zhuj27519-del/AirMonitor/history/stm32/AirMonitor_KEY3_diagnostic/REPORT.md

# AirMonitor KEY3 专项诊断

完成日期：2026-10-28。**KEY3 已确认连通，GUI 与 CLI 完整 DRC 均为 0 错误，可进入下一轮制造审核。**本结论只关闭 KEY3 阻断，不等于整机安全上电或 SMT 下单放行。

| 项目 | 结果 |
|---|---|
| 当前使用工程 | `outputs/AirMonitor_V1_first_article/hardware/EasyEDA/AirMonitor V1 - First Article.eprj3`，不是 `AirMonitor_V1_first_article - fix` |
| 识别依据 | 当前窗口唯一存活用户会话、工程 UUID 与该绝对文件路径 SHA-256 一致；PCB UUID `0d571ee1a4bcf754`；实时走线与磁盘原生几何一致 |
| 原始问题原因 | 早先缺少 KEY3 层间过孔；该过孔已在上一轮加入。之后旧会话仍报两个 Connection Error，但已保存几何与本次通过检查的几何一致。旧会话连通性状态未同步是最符合证据的解释；具体内部缓存/更新缺陷未证实 |
| KEY3 是否真正连通 | **是，按铜几何验证**：U1.44/PB5、R6.2、SW3.1 在同一连通分量；不是只比较网络名称 |
| GUI / CLI 是否一致 | **一致，均 0 错误**。GUI 本轮重新点击完整检查，141 项，完成显示时间 2026-10-27 23:58:30、耗时 00:06；CLI 严格详细模式返回空错误数组 |
| 本轮是否修复 | **没有改线、改过孔或改规则**，未发现需要修复的真实断线 |
| GND 铺铜 | 本轮未改铜几何，所以未重复重填；读取到已有顶/底两个实际填充对象，新 Gerber 两层均有铜区 |
| 最终 DRC 错误数 | **0**；旧报告 2 项，本轮同设计复核 0 项 |
| 新工程路径 | `hardware/EasyEDA/AirMonitor V1 - First Article.eprj3`（相对本报告目录，独立审核副本，电路未修改） |
| 下一轮制造审核 | **可以进入**；电源、机械/线束、SMT 贴装审核等此前待验事项不在本轮放行范围 |

## 两个走线与过孔

所有坐标为 EDA 原生数据坐标换算的 mm；此前错误位置是走线标记中心，不是实际断点。

| UUID | 对象 / 网络 / 铜层 | 实际几何与状态 |
|---|---|---|
| `50ed7851da96bd02`（e1557） | LINE / KEY3 / 顶层 1 | (40.75013186,39.25001294) → (39.67139640,39.25001294)，宽 0.248412；起点在 U1.44 铜盘内，末端与过孔环形铜相交 |
| `3dc5ae6a88fe8cb1`（e1564） | LINE / KEY3 / 底层 2 | (39.82328840,39.09812094) → (39.67139640,39.25001294)，宽 0.248412；连接底层 KEY3 主干及同一过孔环形铜 |
| `9b31158553647615` | NORMAL 镀铜通孔 / KEY3 / 顶底层 | 中心 (39.67139640,39.25001294)，原生孔径/外径约 0.30/0.60；孔壁连接顶底焊环。不是把钻孔中心误当成实铜 |

独立计算包含 12 段走线、1 个镀铜过孔和 3 个实际焊盘。焊盘坐标/形状从官方 pin API 读取，走线和过孔从原生文件及 API 交叉核对。按铜宽、同层接触、环形铜交集及镀铜孔壁建立连接图，16 个对象全部可从 U1.44 到达；仅在计算中移除该过孔时，U1.44 与 R6.2/SW3.1 断开，验证了层间通路的重要性。未依赖 GND 铜区连接 KEY3，未进行实物电测。

## 为何与旧报告不同

旧报告调用 `pcb_Drc.check(true,false,true)`，本轮调用 `pcb_Drc.check(true,true,true)`：中间参数仅控制是否显示 UI，首尾参数均为严格检查及详细错误输出，不是缩小检查范围。GUI 完整检查也独立执行，并非只查看网络过滤结果。

对封存交付 ZIP 与当前 PCB 逐条比较：有效走线、焊盘、过孔、元件布局、铺铜和设计规则未改变；有效语义差异仅铜区/铜框显示隐藏。e1557 的编辑 ticket 更新，但几何、网络和层保持完全相同；有两个临时走线删除记录，均不构成当前铜对象。时间戳和客户端标识变化不代表电路版本变化。

因此，不能把上轮结果简单解释为当前仍有缺孔，或把 GUI 0 错误归因于更宽松的规则。当前证据支持旧会话连通性判定陈旧/未同步；没有调试到 EDA 内部实现，故不把某个缓存缺陷写成已证实原因。此前封存报告的 NO-GO 历史记录保持不动，本报告仅更新 KEY3 这一项结论。

## 文件与保护边界

- `original_project_backup.zip`：本轮任何检查前备份的当前可编辑工程，包含工程索引、PCB、原理图、面板和配置；不混入历史自动备份目录。
- `hardware/EasyEDA/`：独立源工程副本；打开 `.eprj3` 时必须保留相邻文件夹。
- `manufacturing/`：新导出的 Gerber、三类 Drill、原生及 JLC 格式 BOM/CPL。42 元件总表；41 元件 SMT 表，J5 单列手焊。仅供下一轮审核，未提交订单。
- `verification/current-cli-drc.txt`、`gui-drc-observation.json`：本轮原生 DRC 结果及 GUI 观察记录。
- `verification/key3-independent-connectivity.json`：具体连接路径、接触裕量、原生数据比较及负对照。
- `verification/identity-and-backup.json`、`candidate-integrity.json`：工程身份、备份哈希、原始文件不变检查、网表及制造文件一致性。

本轮未改电源、布局、固件或任何设计规则，未重跑全板布线，未忽略 DRC。冻结 ZIP 的 SHA-256 保持不变；当前用户工程文件也逐项检查未被本轮改写。制造候选文件的 PCB/原理图 182 个符号引脚一致，三处 KEY3 引脚均正确；BOM/CPL 42 元件一致，Gerber ZIP CRC 和三类钻孔提取一致性通过。
