zhuj27519-del/AirMonitor/history/stm32/AirMonitor_V1_first_article - fix/FINAL_REPORT.md

# AirMonitor V2 — V1 首版打样冻结报告

2026-10-27。V1 是交付批次名，产品仍为 AirMonitor V2。本交付冻结现有功能、固件和元件选型，不再进行 P3/P4 优化。未提交订单、未上传制造文件、未进行实物上电。

Gerber、Drill、BOM、CPL、可编辑源工程与预览均已导出。可选 STEP 导出超时，本包不包含 STEP，也不使用旧版本 STEP 替代；不再为此重复自动导出。

**制造结论：NO-GO（存在未关闭生产阻断项）。**
**整机安全上电：未验证，不予直接上电放行。直接交付嘉立创 SMT：NO-GO，须完成装配审核。**

| 项目 | 修改前 | 最终实测/检查结果 |
|---|---:|---|
| ERC 错误 | 0 | 0；实际执行，passed=True |
| DRC 错误 | 24：23 项连通性错误 + 1 项网表同步错误 | 2 |
| 实际未连接网络 | 8 | 1；KEY3 |
| 原理图/PCB 同步 | 1 项错误 | 通过；182 个符号引脚逐项比对 |
| 计划连接核对 | 152 个连接 | 全部一致 |
| GND 铜区 | 布线后需重填 | 2 个实际填充对象；顶/底层 Gerber 均包含铜区 |
| 尚未核验的连接器/封装 | 见下文 | 传感器端配套插头、实物 Pin 1、线束；J5/按键实际高度和装配配合；全板 CPL 在嘉立创贴装预览中的旋转、Pin 1、底面朝向尚未人工确认 |
| 是否可制造 | 未放行 | NO-GO（存在未关闭生产阻断项） |
| 是否可安全上电 | 未实测 | **不能宣称通过**；先执行下述分阶段验收 |
| 是否可直接交付嘉立创 SMT | 未审核 | **NO-GO**：双面 SMT、J5 通孔手焊、料号可贴装性/库存及贴装旋转尚未完成下单审核 |

## 对应错误的收敛修改

1. 原 23 项不是 23 个焊盘：其中 21 个是必需连接焊盘，2 个是 KEY3 顶/底层走线。逐项位置、网络和分类见 `verification/v1-connection-and-width-audit.json`。未把它们改为 NC 或忽略错误。
2. eFuse OUT 4–8、IN 9–13 采用厂家 0.20×0.60mm 焊盘后的局部引出线；保持约 0.50mm 主供电走线。EF_EN、EF_ILIM、EF_DVDT、OVP_DIV 的局部控制线采用 0.15mm。未降低铜间距规则。电源入口曾出现的一段 0.20mm 细线已恢复为 0.50mm。
3. C6.2、U2.2 补地连接。KEY3 在 (39.6714, 39.2500)mm 补一个 0.30/0.60mm 过孔，但最终 DRC 仍报两条走线未连接，不能据此宣称 KEY3 已修复。该网络是 U1.44/PB5、R6.2 与 SW3.1 的必需连接，不是 NC。
4. 重新同步原理图变更以修复网表元数据不一致；重建 GND 后执行最终检查。
5. U3.2(PGOOD)、U3.19(IMON)、U3.20(FLT)、U4.1(OUTA) 及未使用 MCU GPIO 按功能允许 NC。NC 与必需连接分开处理。

## P1/P2 汇总及冻结边界

P1 已处理 USB-C 原来的 4 项间距错误、双层地铜、USB4125 电源接口、独立 CC 下拉、PTC/TVS/eFuse 电源链、MCP1826S 3.3V 稳压、八针 PMS 转接线定义及 LCD 安装孔。

P2 已加入的 TLV6700 过压检测保留为冻结设计，不再添加保护功能：U4 的 OUTB 开漏输出拉低 U3.EN；124k/10k 精密分压名义阈值 5.36V。按 TI 全温阈值、输入漏电、电阻初始误差和温漂计算，静态上升阈值约 5.270～5.451V；计算不是实测。eFuse 内部 OVP 保留为后备。未声称具有经过测试的瞬态钳位、完整热插拔保护或模块绝对最大值保证。

已有 P2 修正同时收敛到本包：U3 外围铜盘/焊膏开口采用 TI RVC 示例；EP 两个 1.15×1.47mm 开口、约 81.27% 覆盖，0.10mm 钢网参考。U4 按 TI DDC 推荐 1.10×0.60mm 焊盘、0.95mm 节距核对。J4 两个固定焊盘从 x=±9.85mm 修正至 ±9.35mm，与 JST PH 安装图的横向定位一致。原理图和 PCB 内嵌封装资源读回一致。

固件与 P1 提交 `ad4e2493cffe687d613dfba4a7fd445f3fbed14e` 相比未改变。沿用已实际执行的 CubeIDE 编译（0 错误/0 警告）及 107 项 ARM 协议解析断言记录；本轮未重跑、未上硬件。保留源代码和 ELF/HEX/BIN。

## 关键封装核验范围

| 对象 | 已完成的软件/图纸核验 | 不宣称已完成的事项 |
|---|---|---|
| J1 USB4125-GF-A-0190 | GCT 图纸、六针/四壳脚、A9/B9 0.76×1.20mm 铜盘、0.60×1.20mm 壳槽及 CC 独立下拉 | 插头插拔、板边和外壳实配 |
| U3 TPS25940 | 20 脚+EP 引脚网络、0.50mm 节距、厂家焊盘与钢网尺寸、EP 直连 GND | 焊接空洞率、实测限流/热保护/瞬态响应 |
| U4 TLV6700 | 六针逻辑和接线、厂家推荐焊盘、分压计算 | 实测动作/释放阈值和启动瞬态 |
| U2 MCP1826S | IN1/GND2/OUT3/tab4；2.30mm 节距；现有扩大铜盘覆盖厂家推荐接触区域 | 两层 PCB 热阻、满载温升、实际电容偏压后的有效容量 |
| U1 STM32G0B1CBT6 | 非 N 版本引脚、电源/SWD、48脚0.50mm节距、7×7mm本体；库0.27×1.50mm铜盘与ST0.30×1.20mm示例差异已记录，未误称完全相同 | 装配厂贴装旋转终审、实板焊接验收 |
| J2/J3/J4 JST PH | 2mm节距、各针网络；J2固定盘横向距边针约2.40mm、J3/J4约2.35mm；J4固定盘已纠正；J4在底面 | 线束配套插头、锁扣空间、实际底面安装方向验收 |
| F1/D1、标准R/C及开关 | 精确BOM料号、极性/网络、库尺寸及DRC；未宣称逐件实物验证 | 非关键标准封装未做完整厂家叠图，装配厂复核型号/极性/钢网与供料 |

主要电源干线仍约 0.50mm；QFN 邻近短段存在 0.20mm，3V3 既有局部颈部约 0.248mm。具体长度和坐标见线宽审计。**没有完成实际电流和温升测试**，不可将 DRC 通过等同于热设计认证。

## 下单范围与制造参数

仅在本报告裸 PCB 结论为 GO 时使用 `manufacturing/AirMonitor_V1_Gerber_REVIEW.zip` 下裸板样单。尺寸 102×80mm；2 层 FR-4、1.6mm、1oz 铜；建议绿色阻焊、白色字符、ENIG；无阻抗控制要求。存在四个 USB 镀铜槽和八个 Ø3.2mm 非金属孔；不得把 PTH 槽改成 NPTH。采用板厂最终 DFM 审核，不声称本轮已上传并通过嘉立创在线 DFM。

BOM/CPL `all` 版本包含 42 个 PCB 元件；`SMT` 版本包含 41 个，J5 单列手焊。CPL 坐标以 mm 导出，保留 EDA 原生旋转与 Top/Bottom 层；未为通过导入而猜改角度。选择 SMT 时，必须在厂商装配预览逐个确认 U1/U2/U3/U4、D1、J1～J4 和底面元件的 Pin 1/极性，并确认指定料号可供料、可贴装。外部传感器、LCD、线束和支柱不在 SMT CPL 内。

嘉立创公开能力参考：<https://jlcpcb.com/capabilities/pcb-capabilities>。本设计的 0.15mm 局部信号线、0.30mm 过孔和 0.60mm 镀铜槽在该公开规格范围内；这不等于订单审核已通过。

## 人工验收与首次上电

1. 裸板/装配后先检查 VBUS、5V_FUSED、5V、3V3 对地无硬短路，检查 USB 壳槽、QFN 焊桥、D1 极性和 LDO 型号/方向。未执行这些实物检查。
2. 初次只给主板提供受限的 5.0V 电源，不接传感器和 LCD；确认无异常电流、发热，测量 5V/3V3 后再进行 SWD 下载。随后逐个接外设并观察电压跌落和电流。不要同时从 SWD 强行供电。
3. 在外设断开的专门测试中验证 OVP、限流、短路恢复和负载温升，再确认整机供电余量。不得在传感器连接状态下直接做过压试验。
4. PMS 使用用户确认的八针接口：主板 J2 的 1/2/3/4/5/6 → 传感器 1/2/5/4/3/6，传感器7/8悬空。21VOC仅3.3V。针1和每根线必须实物导通确认，不能按线色或照片朝向接线。
5. Waveshare 18079 的 PH 口与主板针序相反，按 `documentation/interfaces.md` 逐信号检查；实物显示模块版本、LCD孔位/支柱高度、按键高度、线束弯折和外壳均待试装。

## 未解决的制造阻断：KEY3

最终完整 DRC 实际完成，报告两条走线与同网其他对象断开：

| 网络/层 | DRC 对象与永久 ID | DRC 标记位置（mm） |
|---|---|---|
| KEY3 / 顶层 | e1557 / 50ed7851da96bd02 | (40.2108, 39.2500) |
| KEY3 / 底层 | e1564 / 3dc5ae6a88fe8cb1 | (39.7473, 39.1741) |

文件：`hardware/EasyEDA/pcb/PCB1.epcb2`。所加过孔 ID 为 `9b31158553647615`，源文件中网络 KEY3、坐标 (39.6714,39.2500)mm、孔径/外径 0.30/0.60mm 已保存。两条线的端点数值与过孔中心相同，但 DRC 仍未认可连通性。**最终未连接的几何/EDA 内部判定原因尚未确定，不能凭坐标相同把错误忽略。**人工应在原生工程中定位上述两个对象，检查端点吸附、同网连接及 U1.44 至 R6/SW3 的完整路径，修复后重新填铜并执行完整 DRC。按用户停止条件，本轮不再进行自动修复尝试。

原生错误明细在 `verification/v1-drc-final.txt`，精确坐标和对象列表在 `verification/remaining-errors.csv`。第一次命令等待超时后延长等待取得最终结果；超时不计为通过。当前 2 项错误是硬性 NO-GO，禁止用本包下生产订单。实物验收、贴装审核和保护动态/热性能也均未完成。所有自动设计迭代在本次交付后结束。
