zhuj27519-del/AirMonitor/history/stm32/AirMonitor_V2/verification/report.md

# V2-P1 工程验证报告

日期：2026-10-27。**本次已消除 P0 的四项 USB 间距错误并完成两层实际地铜；仍为工程审查版，未批准制造。**

## 验收矩阵

| 项目 | 当前结果 | 证据/限制 |
|---|---|---|
| 原生工程持久化 | 通过重开验证 | 两次关闭/重开，USB 焊盘宽度与热连接从文件读回；p1-native-readback.json |
| ERC | 0 项，passed=true | p1-erc-final.txt |
| 含地铜的原生 DRC | 0 项 | p1-drc-final.txt：errors=[]、filled=2；没有降低 0.20mm 间距规则 |
| 引脚网表比对 | 168 个符号引脚一致；139 项计划连接一致 | independent-checks.json；电气分网与几何连通性分别验证 |
| 布线 | 37 器件、433 段走线、38 过孔 | p1-state-final.txt；初始路由 442 段，保存/重开后原生整理为 433 段 |
| 地铜 | 两层实际填充 | Gerber Top/Bottom 的 G36 区域数量：{'Gerber_TopLayer.GTL': 4, 'Gerber_BottomLayer.GBL': 2}；不是只有边界 |
| 物理叠层 | 已核实并保存 | 1.6mm total；FR4 1.51mm；两面铜各 35µm，两面阻焊各 10µm；不是板厂实测公差 |
| USB 封装 | 已解决原四项 DRC 冲突 | USB4125 取代 USB4105；两个电源铜盘 0.76mm 宽，四个壳脚槽与图纸核对 |
| 电源保护 | 电路修订完成，整体验收未完成 | PTC→TVS/eFuse→5V→SOT223 LDO；OVP 温漂/瞬态余量仍不足以保证 5.5V 上限 |
| LCD 机械 | 官方孔位已加入 | 44×29mm 中心距、4×Ø3.2mm；支柱高度、线束与外壳需试装 |
| 颗粒物线束 | 按用户确认的八针接口定义完成 | J2 1/2/3/4/5/6 → 传感器 1/2/5/4/3/6；7/8 NC；使用模块配套八针插头 |
| 全部封装/钢网/CPL | 未完成最终装配验收 | footprint-review.md，特别是 U3 库焊盘与 TI 示例差异、JST 锚脚及钢网 |
| 制造导出 | P1 已生成，未发布 | Gerber、钻孔、BOM、CPL、网表、PNG、STEP，完整性见 delivery-checks.json |
| 固件 | 保留先前通过的构建和测试 | 电源/封装改版未改 MCU 引脚或解析源码；cubeide-build-final.txt、protocol-tests-final.txt |
| 真实硬件验证 | 未执行 | 未烧录、未测试八针模块帧、启动电流、显示背光、温升或保护波形 |

## 已关闭问题及复核方式

P0 铜边界使用的矩形坐标约定导致区域偏离板框。改成明确闭合顶点后 GUI 可以填铜。重新布线后的首次填铜后台停滞，停止并重开本任务编辑会话后成功；最终以 filled 对象、原生 DRC 和 Gerber 区域同时证明完成。未伪造铜层填充数据。

原理图/PCB 曾出现一项 Netlist Error。独立逐引脚比较没有分网差异，发现旧器件的 Channel ID 元数据未同步；通过原生 importChanges 同步后，重开及最终 DRC 均通过。未隐藏该项检查。

组件子焊盘 API setter 曾未能跨重开持久化。按官方 TPcbPad / EPadConnect 格式修订工程内嵌封装资源，两份原生文档同步；再重开核验 A9/B9=0.76mm、U2 tab4/U3 EP21=DIRECT，并重新补铜。证据为 p1-native-footprint-edits.json 与 p1-native-readback.json。

## 制造前仍需关闭

1. 电源：OVP 名义 5.3757V；含器件阈值、漏电和初始电阻公差为 5.2540–5.4978V，未计电阻温漂和过冲。不能保证传感器始终低于 5.5V；需更严格阈值电路或实际模块允许瞬态范围及资格测试。测背光电流、PMS 启动、PTC 压降、LDO/eFuse 温升。
2. 装配：依据各厂家图纸完成所有封装/极性/钢网/底面旋转的终审。U3 库外围焊盘与 TI 示例不同，不能把 DRC 0 当作装配验收。
3. 线束/机械：八针电气接口已按用户要求确定，不再将“必须改回十针”作为前提；传感器端用配套线，21VOC 插座仍需实物核对。验证显示支柱、线缆和外壳，保持传感器气流隔离。
4. 固件/样机：捕获实际八针模块 UART 帧后核对现有 32 字节解析器；执行 bringup.md。当前仅有主机解析器测试，没有真实模块功能验证。

以上限制是具体工程未验收项，不是由已解决的 USB/补铜问题推导的泛泛警告。任何后续电路或封装变更都要重新布线/补铜、ERC/DRC、网表比对和制造导出。

## 文件与证据边界

P1 的全部最终导出来自同一保存后的工程。历史 P0 日志不覆盖 P1 结果。BOM/CPL 为原生 Tab 分隔，不能假设已经匹配装配厂订单格式。三维模型、文件 CRC 和哈希只证明可读取与一致性，不构成机械/电气认证。
