zhuj27519-del/AirMonitor/docs/AUDIT.md

# 恢复检查报告 — 2026-11-12

## 搜索范围

对 C:\、D:\ 使用 rg --files --hidden --no-ignore 建立可读取文件索引，按 AirMonitor、ESP8266、ESP-12F、PMS7003M、21VOC、OLED、HF035 和 Arduino 扩展名筛选；另按 Arduino/EDA 文件内容搜索项目关键词。系统保护目录存在访问拒绝；压缩包内部与二进制缓存不宣称全部检索。第三方 Arduino 库/SDK 和同名无关文件不作为本项目源码复制。相关搜索清单与错误日志保存在 local-only/search，防止无关本机路径发布。

## 完整性与验证

主源码包含 setup/loop、PMS/VOC 接收与校验、显示更新；所需依赖可由已安装的 ESP8266 core 3.1.2 提供。Arduino CLI 编译已通过，未连接/烧录硬件。初次沙箱编译失败于系统 DLL 地址冲突，在正常主机环境编译成功。完整输出保存在 local-only/validation。

所有复制文件按 SHA-256 校验，索引见 inventory.json。原始文件未删除；Git bundle 保留旧提交，目录快照包含旧仓库未提交改动。

## 未关闭的代码问题

- ESP8266 21VOC 温度直接转 int16_t；STM32 历史文档说明负值使用反码幅值，两者不一致。待真实传感器手册/帧确认后修正，当前没有擅自改变数值含义。
- PMS 主解析器没有依据传感器错误字节屏蔽读数；噪声重同步后的帧头/长度应补充针对性测试。
- IRAM 94%，双软件串口在实际负载下的持续接收尚未验证。
- HF035 接线注释使用屏端 TX 标签，但其方向不能仅凭标签推定；应核对模块资料。
- 历史 README 的构建/测试通过是旧证据，本次仅复核主 ESP8266 编译，未重新验证所有 STM32 硬件与固件。

## 敏感信息策略

主固件未包含 Wi-Fi 登录逻辑。仓库对待提交文本执行凭据模式扫描；高风险文件名、私钥和未审核归档排除。扫描是规则检查，不能证明所有二进制内容无隐私。订单 PDF 和旧 Git 历史保留本地，不推送。最初按用户要求发布为 Private；用户后续明确要求公开后已改为 Public，并通过无 Authorization 请求验证匿名访问。后续提交仍须检查凭据和个人信息。

本次首次扫描覆盖 754 个待提交文本文件，未发现所定义的凭据模式；76 个二进制文件未做文本扫描。完整结构化结果见 secret-scan.json。

## GitHub 首次发布验证

仓库 zhuj27519-del/AirMonitor 已确认 Private，首次提交 cd4b17d26d1ae98dec1cfe791218f23c033e5919 已推送；远端提交与文件树均匹配本地。授权过程和网络重试不改变已恢复源码。
