zhuj27519-del/AirMonitor/hardware/hmi/assets/AirMonitor_V4_Background_212x318.bmp

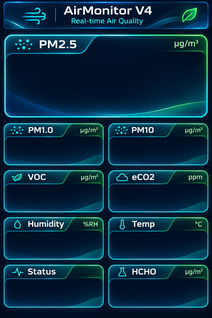
hardware/hmi/assets/AirMonitor_V4_Background_212x318.bmp
