zhuj27519-del/AirMonitor/hardware/hmi/assets/AirMonitor_V4_preview_212x318.bmp

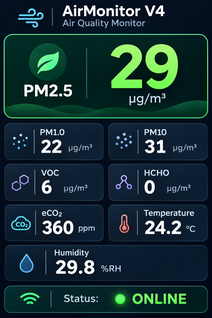
hardware/hmi/assets/AirMonitor_V4_preview_212x318.bmp
