zhuj27519-del/AirMonitor/hardware/sensors/21voc/6c0f5fe15c807db3d65c640978f76d1c.jpg

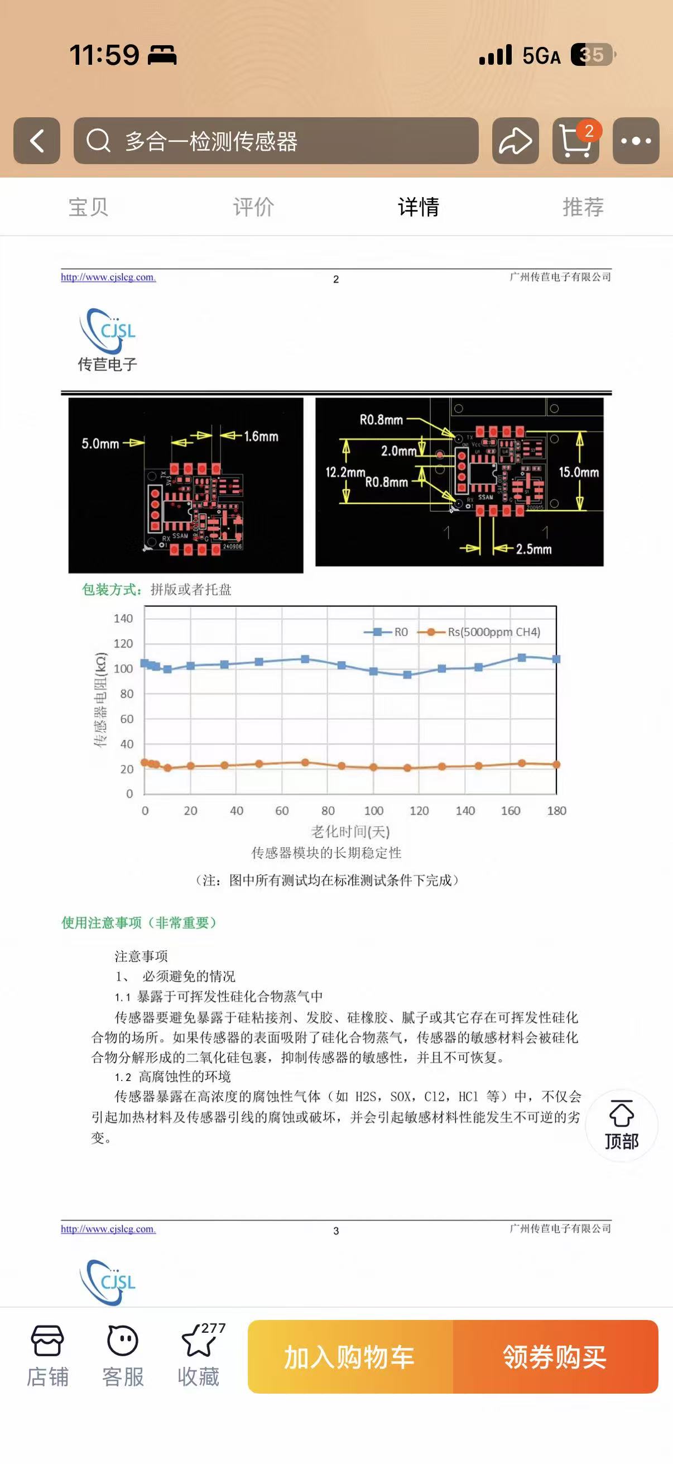
hardware/sensors/21voc/6c0f5fe15c807db3d65c640978f76d1c.jpg
