zhuj27519-del/AirMonitor/hardware/sensors/21voc/96eb477987dba18f5265ee34690fde97.jpg

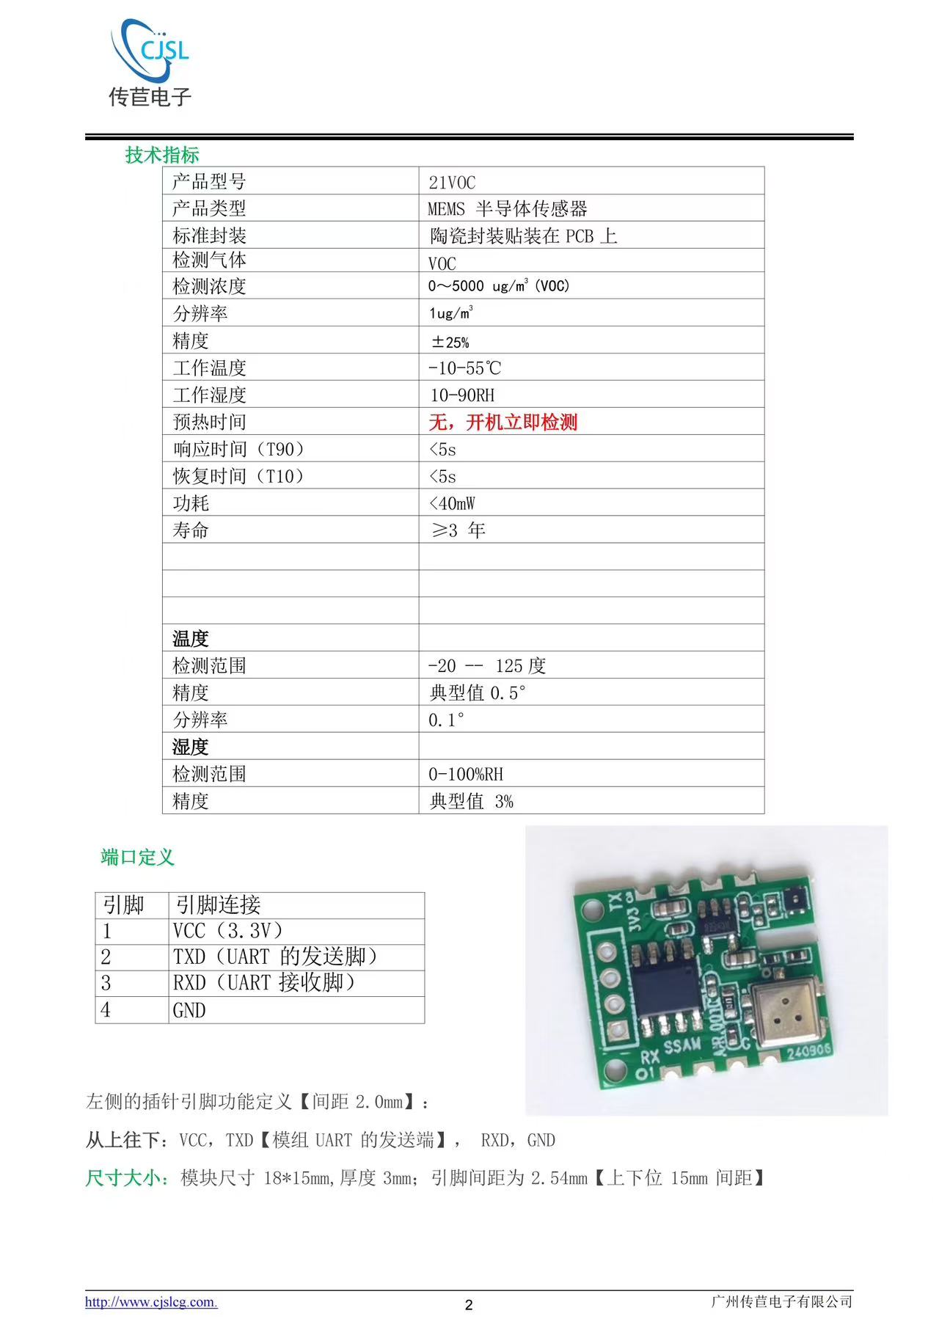
hardware/sensors/21voc/96eb477987dba18f5265ee34690fde97.jpg
