zhuj27519-del/AirMonitor/hardware/sensors/21voc/d2af0fff95c0b9f44d673007e6fd1f0e.jpg

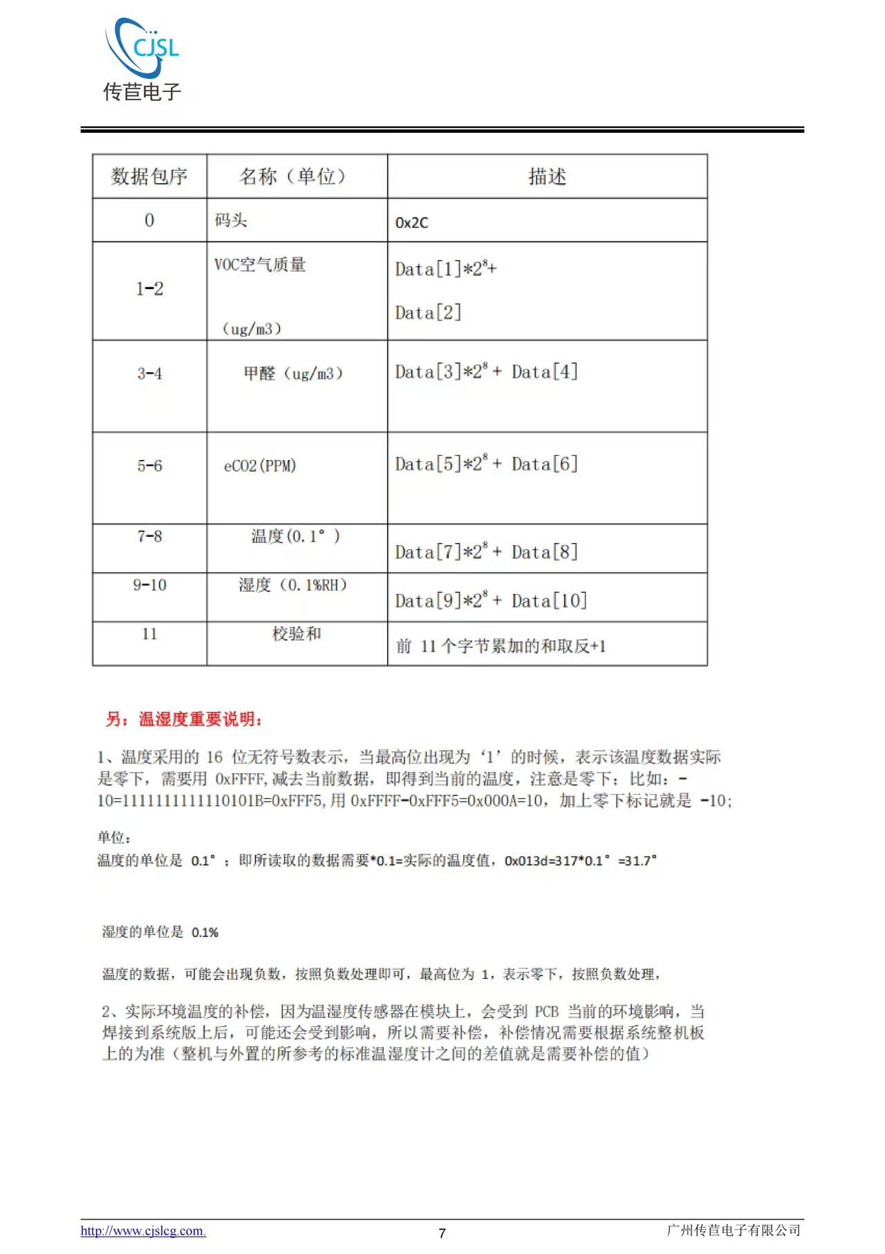
hardware/sensors/21voc/d2af0fff95c0b9f44d673007e6fd1f0e.jpg
