zhuj27519-del/AirMonitor/hardware/sensors/21voc/d406f99c3d1587cd0746fb499f8712e6.jpg

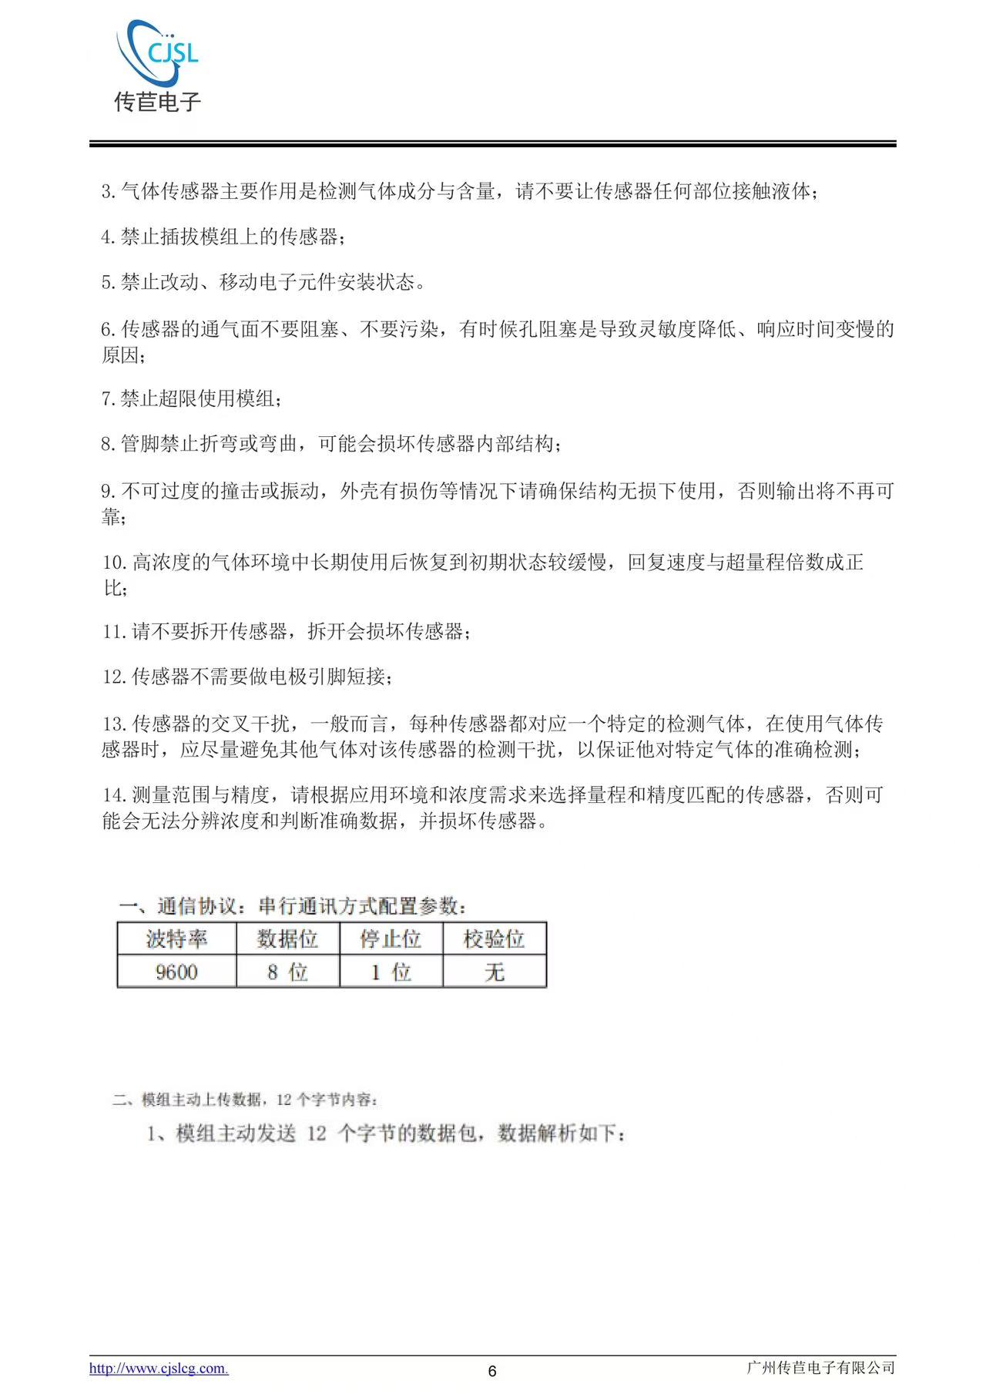
hardware/sensors/21voc/d406f99c3d1587cd0746fb499f8712e6.jpg
