zhuj27519-del/AirMonitor/hardware/sensors/21voc/ffd40b1e6fdbc095ca067237d3dfe453.jpg

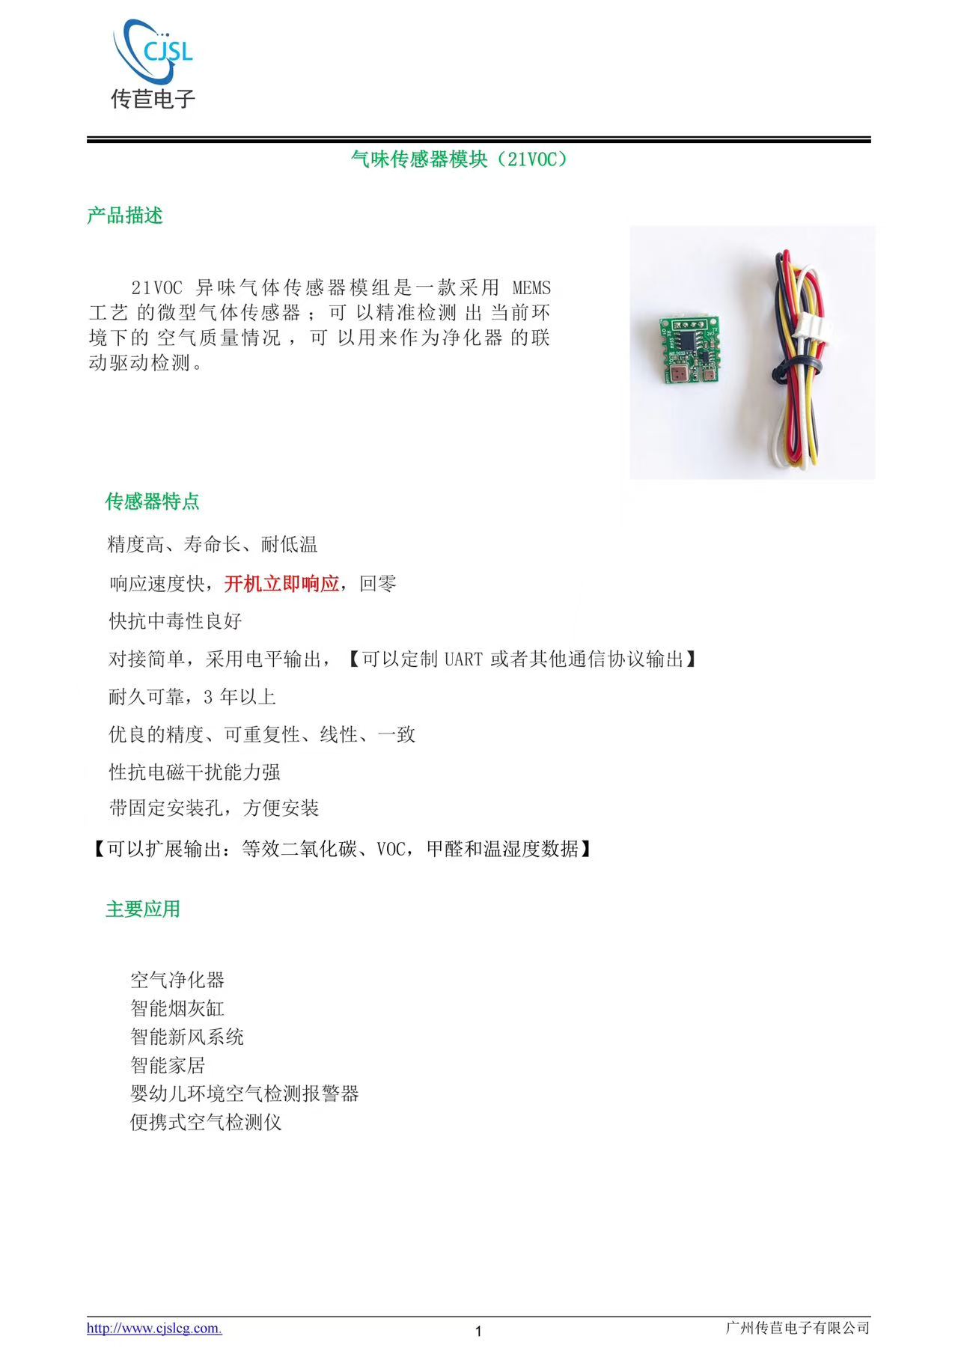
hardware/sensors/21voc/ffd40b1e6fdbc095ca067237d3dfe453.jpg
