zhuj27519-del/AirMonitor/history/hardware/KiCad-V1_5-DRAFT/AirMonitor_V1_5_Prototype_KiCad/PCB_front_routed.png

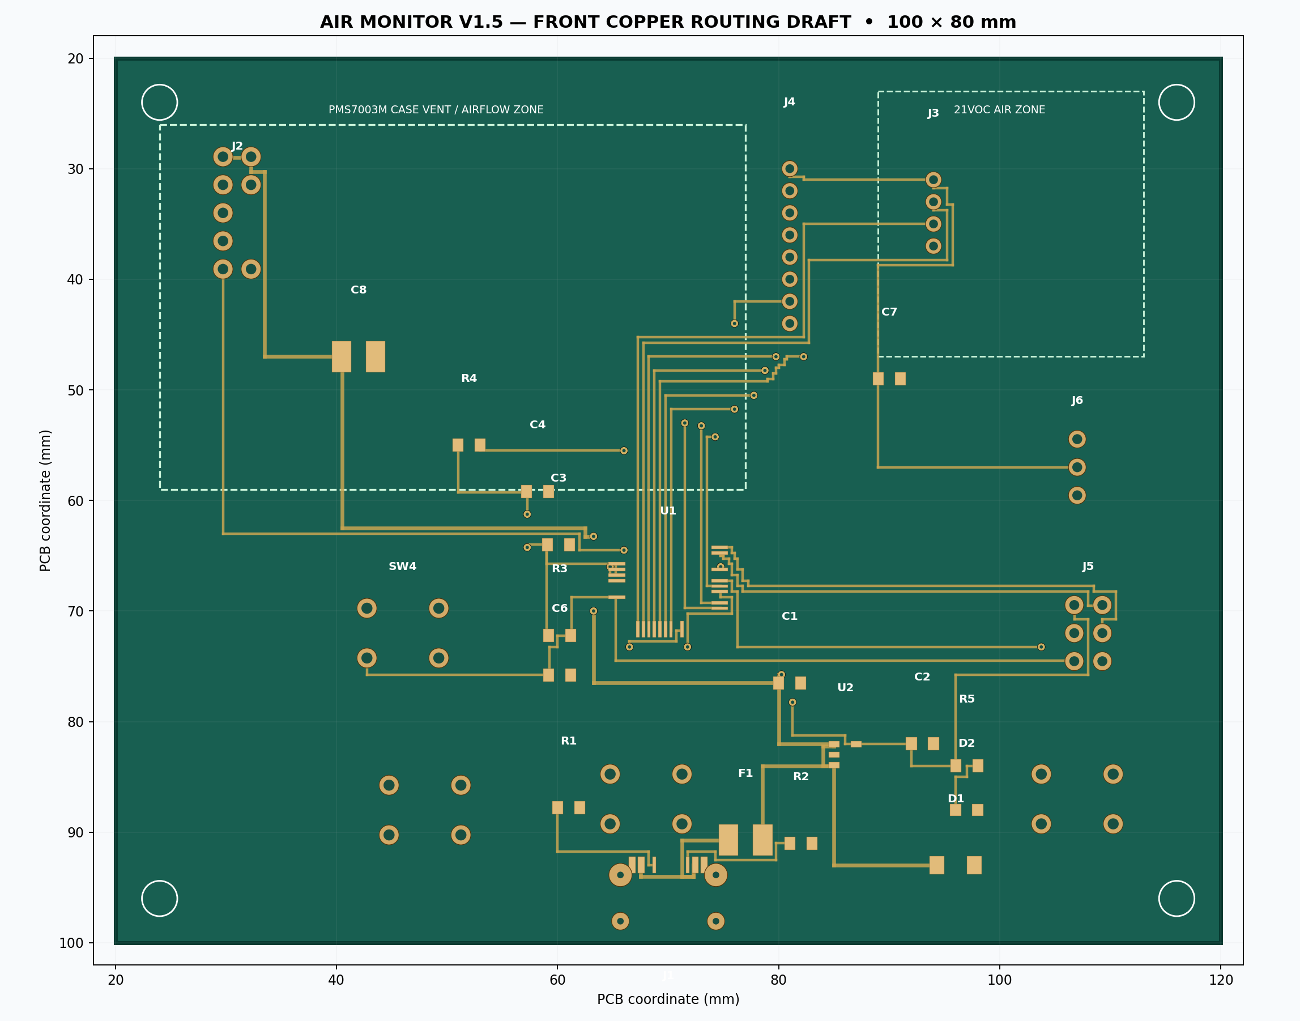
history/hardware/KiCad-V1_5-DRAFT/AirMonitor_V1_5_Prototype_KiCad/PCB_front_routed.png
