zhuj27519-del/AirMonitor/history/stm32/AirMonitor_V1_first_article - fix/hardware/pcb-back-layer-top-view.png

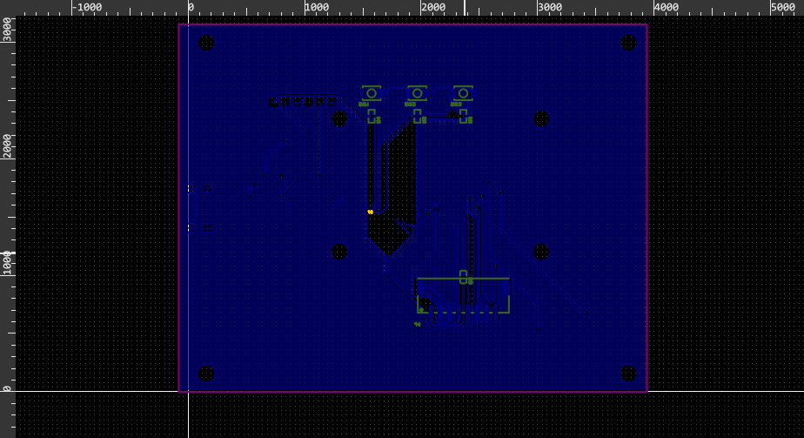
history/stm32/AirMonitor_V1_first_article - fix/hardware/pcb-back-layer-top-view.png
