zhuj27519-del/AirMonitor/history/stm32/AirMonitor_V1_first_article - fix/hardware/schematic-preview.png

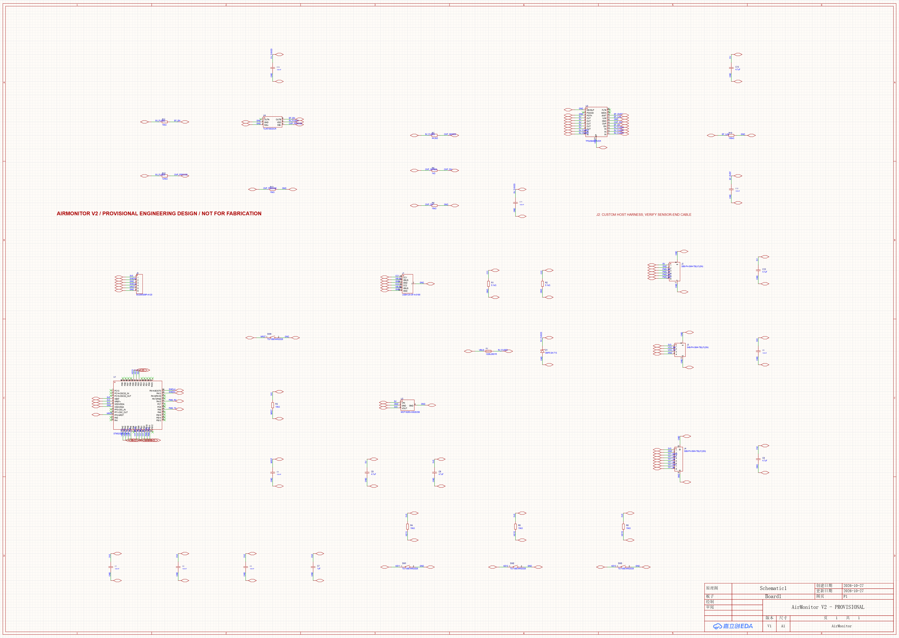
history/stm32/AirMonitor_V1_first_article - fix/hardware/schematic-preview.png
