zhuj27519-del/AirMonitor/history/stm32/AirMonitor_V1_first_article - fix/manufacturing/DO_NOT_ORDER.md

# NO-GO — 仅供人工审查

当前完整 DRC 仍报告 KEY3 两项连通性错误。禁止直接用本目录文件下单或生产。

Gerber、钻孔、BOM、CPL 均由同一冻结设计导出。源工程和具体错误位置见上级 FINAL_REPORT.md。文件完整性通过不代表制造、上电或 SMT 放行。
