zhuj27519-del/AirMonitor/history/stm32/AirMonitor_KEY3_diagnostic/manufacturing/BOM-manual.csv

Comment | Designator | Footprint | LCSC Part #
B-2200S06P-A120 | J5 | HDR-TH_6P-P2.54-V-F | C124415
