zhuj27519-del/AirMonitor/history/hardware/KiCad-V1_5-DRAFT/AirMonitor_V1_5_Prototype_KiCad/net_connections.csv

Reference | Pin number | MCU pin name where applicable | Net | x_mm | y_mm | Side
U1 | 1 | PC13 |  | 65.35 | 64.25 | F
U1 | 2 | PC14 |  | 65.35 | 64.75 | F
U1 | 3 | PC15 |  | 65.35 | 65.25 | F
U1 | 4 | VBAT | 3V3 | 65.35 | 65.75 | F
U1 | 5 | VREF+ | 3V3 | 65.35 | 66.25 | F
U1 | 6 | VDD/VDDA | 3V3 | 65.35 | 66.75 | F
U1 | 7 | VSS/VSSA | GND | 65.35 | 67.25 | F
U1 | 8 | PF0 |  | 65.35 | 67.75 | F
U1 | 9 | PF1 |  | 65.35 | 68.25 | F
U1 | 10 | PF2/NRST | NRST | 65.35 | 68.75 | F
U1 | 11 | PA0 |  | 65.35 | 69.25 | F
U1 | 12 | PA1 |  | 65.35 | 69.75 | F
U1 | 13 | PA2 | MCU_TX_TO_VOC | 67.25 | 71.65 | F
U1 | 14 | PA3 | VOC_TX_TO_MCU | 67.75 | 71.65 | F
U1 | 15 | PA4 | LCD_CS | 68.25 | 71.65 | F
U1 | 16 | PA5 | LCD_CLK | 68.75 | 71.65 | F
U1 | 17 | PA6 | LCD_DC | 69.25 | 71.65 | F
U1 | 18 | PA7 | LCD_MOSI | 69.75 | 71.65 | F
U1 | 19 | PB0 | LCD_RST | 70.25 | 71.65 | F
U1 | 20 | PB1 |  | 70.75 | 71.65 | F
U1 | 21 | PB2 | KEY_1 | 71.25 | 71.65 | F
U1 | 22 | PB10 |  | 71.75 | 71.65 | F
U1 | 23 | PB11 |  | 72.25 | 71.65 | F
U1 | 24 | PB12 |  | 72.75 | 71.65 | F
U1 | 25 | PB13 | PMS_SET | 74.65 | 69.75 | F
U1 | 26 | PB14 | PMS_RESET | 74.65 | 69.25 | F
U1 | 27 | PB15 |  | 74.65 | 68.75 | F
U1 | 28 | PA8 | KEY_2 | 74.65 | 68.25 | F
U1 | 29 | PA9 | MCU_TX_TO_PMS | 74.65 | 67.75 | F
U1 | 30 | PC6 | KEY_3 | 74.65 | 67.25 | F
U1 | 31 | PC7 |  | 74.65 | 66.75 | F
U1 | 32 | PA10 | PMS_TX_TO_MCU | 74.65 | 66.25 | F
U1 | 33 | PA11 |  | 74.65 | 65.75 | F
U1 | 34 | PA12 |  | 74.65 | 65.25 | F
U1 | 35 | PA13/SWDIO | SWDIO | 74.65 | 64.75 | F
U1 | 36 | PA14/SWCLK | SWCLK | 74.65 | 64.25 | F
U1 | 37 | PA15 |  | 72.75 | 62.35 | F
U1 | 38 | PD0 |  | 72.25 | 62.35 | F
U1 | 39 | PD1 |  | 71.75 | 62.35 | F
U1 | 40 | PD2 |  | 71.25 | 62.35 | F
U1 | 41 | PD3 |  | 70.75 | 62.35 | F
U1 | 42 | PB3 |  | 70.25 | 62.35 | F
U1 | 43 | PB4 |  | 69.75 | 62.35 | F
U1 | 44 | PB5 |  | 69.25 | 62.35 | F
U1 | 45 | PB6 |  | 68.75 | 62.35 | F
U1 | 46 | PB7 |  | 68.25 | 62.35 | F
U1 | 47 | PB8 |  | 67.75 | 62.35 | F
U1 | 48 | PB9 |  | 67.25 | 62.35 | F
J1 | A6 |  |  | 69.75 | 92.955 | F
J1 | B5 |  | CC2 | 71.75 | 92.955 | F
J1 | A8 |  |  | 71.25 | 92.955 | F
J1 | B6 |  |  | 70.75 | 92.955 | F
J1 | A7 |  |  | 70.25 | 92.955 | F
J1 | B7 |  |  | 69.25 | 92.955 | F
J1 | A5 |  | CC1 | 68.75 | 92.955 | F
J1 | B8 |  |  | 68.25 | 92.955 | F
J1 | A12 |  | GND | 73.25 | 92.955 | F
J1 | B4 |  | USB_5V | 72.45 | 92.955 | F
J1 | A4 |  | USB_5V | 67.55 | 92.955 | F
J1 | A1 |  | GND | 66.75 | 92.955 | F
J1 | B12 |  | GND | 66.75 | 92.955 | F
J1 | B9 |  | USB_5V | 67.55 | 92.955 | F
J1 | A9 |  | USB_5V | 72.45 | 92.955 | F
J1 | B1 |  | GND | 73.25 | 92.955 | F
J1 | S1 |  | GND | 74.32 | 98.05 | F
J1 | S1 |  | GND | 65.68 | 98.05 | F
J1 | S1 |  | GND | 65.68 | 93.87 | F
J1 | S1 |  | GND | 74.32 | 93.87 | F
J1 |  |  |  | 67.11 | 94.4 | F
J1 |  |  |  | 72.89 | 94.4 | F
F1 | 1 |  | USB_5V | 75.45 | 90.7 | F
F1 | 2 |  | 5V | 78.55 | 90.7 | F
R1 | 1 |  | CC1 | 60.0 | 87.8 | F
R1 | 2 |  | GND | 62.0 | 87.8 | F
R2 | 1 |  | CC2 | 81.0 | 91 | F
R2 | 2 |  | GND | 83.0 | 91 | F
U2 | 1 |  | 5V | 85 | 82.05 | F
U2 | 2 |  | GND | 85 | 83 | F
U2 | 3 |  | 5V | 85 | 83.95 | F
U2 | 4 |  |  | 87 | 83.95 | F
U2 | 5 |  | 3V3 | 87 | 82.05 | F
C1 | 1 |  | 5V | 80.0 | 76.5 | F
C1 | 2 |  | GND | 82.0 | 76.5 | F
C2 | 1 |  | 3V3 | 92.0 | 82 | F
C2 | 2 |  | GND | 94.0 | 82 | F
C3 | 1 |  | 3V3 | 59.1 | 64.0 | F
C3 | 2 |  | GND | 61.1 | 64.0 | F
C4 | 1 |  | 3V3 | 57.2 | 59.2 | F
C4 | 2 |  | GND | 59.2 | 59.2 | F
R3 | 1 |  | 3V3 | 59.2 | 72.2 | F
R3 | 2 |  | NRST | 61.2 | 72.2 | F
C6 | 1 |  | NRST | 59.2 | 75.8 | F
C6 | 2 |  | GND | 61.2 | 75.8 | F
D1 | K |  | 5V | 94.3 | 93 | F
D1 | A |  | GND | 97.7 | 93 | F
J2 | 1 |  | 5V | 29.73 | 28.92 | F
J2 | 2 |  | 5V | 32.27 | 28.92 | F
J2 | 3 |  | GND | 29.73 | 31.46 | F
J2 | 4 |  | GND | 32.27 | 31.46 | F
J2 | 5 |  | PMS_RESET | 29.73 | 34.0 | F
J2 | 6 |  |  | 32.27 | 34.0 | F
J2 | 7 |  | MCU_TX_TO_PMS | 29.73 | 36.54 | F
J2 | 8 |  |  | 32.27 | 36.54 | F
J2 | 9 |  | PMS_TX_TO_MCU | 29.73 | 39.08 | F
J2 | 10 |  | PMS_SET | 32.27 | 39.08 | F
J3 | 1 |  | 3V3 | 94 | 31 | F
J3 | 2 |  | VOC_TX_TO_MCU | 94 | 33 | F
J3 | 3 |  | MCU_TX_TO_VOC | 94 | 35 | F
J3 | 4 |  | GND | 94 | 37 | F
J4 | 1 |  | 3V3 | 81 | 30 | F
J4 | 2 |  | GND | 81 | 32 | F
J4 | 3 |  | LCD_MOSI | 81 | 34 | F
J4 | 4 |  | LCD_CLK | 81 | 36 | F
J4 | 5 |  | LCD_CS | 81 | 38 | F
J4 | 6 |  | LCD_DC | 81 | 40 | F
J4 | 7 |  | LCD_RST | 81 | 42 | F
J4 | 8 |  | LCD_BL | 81 | 44 | F
R4 | 1 |  | 3V3 | 51.0 | 55.0 | F
R4 | 2 |  | LCD_BL | 53.0 | 55.0 | F
J5 | 1 |  | 3V3 | 106.73 | 69.46 | F
J5 | 2 |  | SWDIO | 109.27 | 69.46 | F
J5 | 3 |  | GND | 106.73 | 72.0 | F
J5 | 4 |  | SWCLK | 109.27 | 72.0 | F
J5 | 5 |  | NRST | 106.73 | 74.54 | F
J5 | 6 |  | GND | 109.27 | 74.54 | F
SW1 | 1 |  | KEY_1 | 44.75 | 85.75 | B
SW1 | 1 |  | KEY_1 | 44.75 | 90.25 | B
SW1 | 2 |  | GND | 51.25 | 85.75 | B
SW1 | 2 |  | GND | 51.25 | 90.25 | B
SW2 | 1 |  | KEY_2 | 64.75 | 84.75 | B
SW2 | 1 |  | KEY_2 | 64.75 | 89.25 | B
SW2 | 2 |  | GND | 71.25 | 84.75 | B
SW2 | 2 |  | GND | 71.25 | 89.25 | B
SW3 | 1 |  | KEY_3 | 103.75 | 84.75 | B
SW3 | 1 |  | KEY_3 | 103.75 | 89.25 | B
SW3 | 2 |  | GND | 110.25 | 84.75 | B
SW3 | 2 |  | GND | 110.25 | 89.25 | B
R5 | 1 |  | 3V3 | 96.0 | 84 | F
R5 | 2 |  | LED_K | 98.0 | 84 | F
D2 | A |  | LED_K | 96 | 88 | F
D2 | K |  | GND | 98 | 88 | F
J6 | 1 |  | 5V | 107 | 54.46 | F
J6 | 2 |  | 3V3 | 107 | 57.0 | F
J6 | 3 |  | GND | 107 | 59.54 | F
SW4 | 1 |  | NRST | 42.75 | 69.75 | F
SW4 | 1 |  | NRST | 42.75 | 74.25 | F
SW4 | 2 |  | GND | 49.25 | 69.75 | F
SW4 | 2 |  | GND | 49.25 | 74.25 | F
H1 |  |  |  | 24 | 24 | F
H2 |  |  |  | 116 | 24 | F
H3 |  |  |  | 24 | 96 | F
H4 |  |  |  | 116 | 96 | F
