zhuj27519-del/AirMonitor/history/stm32/AirMonitor_KEY3_diagnostic/manufacturing/BOM-JLCPCB-all.csv

Comment | Designator | Footprint | LCSC Part #
CC0603KRX7R9BB104 | C1,C2,C3,C4,C9,C11,C12,C14 | C0603 | C14663
CL10A475KO8NNNC | C5,C6,C8,C10,C13 | C0603 | C19666
CL10A105KB8NNNC | C7 | C0603 | C15849
SMF5.0A-T13 | D1 | SOD-123F_L2.7-W1.7-LS3.6-RD | C1977665
1206L050YR | F1 | F1206 | C163512
USB4125-GF-A-0190 | J1 | TYPE-C-SMD_TYPE-C-6P_USB4125-GF-A-0190 | C5246813
S6B-PH-SM4-TB(LF)(SN) | J2 | CONN-SMD_S6B-PH-SM4-TB-LF-SN | C265405
S4B-PH-SM4-TB(LF)(SN) | J3 | CONN-SMD_S4B-PH-SM4-TB-LF-SN | C265102
S8B-PH-SM4-TB(LF)(SN) | J4 | CONN-SMD_8P-P2.00_S8B-PH-SM4-TB-LF-SN | C265121
B-2200S06P-A120 | J5 | HDR-TH_6P-P2.54-V-F | C124415
0603WAF5101T5E | R1,R2 | R0603 | C23186
0603WAF1002T5E | R3,R4,R5,R6,R11 | R0603 | C25804
RT0603BRD0744K2L | R7 | R0603 | C861410
0603WAF1001T5E | R8 | R0603 | C21190
RT0603BRD0710KL | R9,R13 | R0603 | C95204
0603WAF1503T5E | R10 | R0603 | C22807
RT0603BRD07124KL | R12 | R0603 | C861097
TS-1088-AR02026 | SW1,SW2,SW3,SW4 | SW-SMD_L3.9-W3.0_TS-1088-AR02026 | C52175904
STM32G0B1CBT6 | U1 | LQFP-48_L7.0-W7.0-P0.50-LS9.0-BL | C2847904
MCP1826S-3302E/DB | U2 | SOT-223-3_L6.7-W3.7-P2.30-LS7.0-BR | C638624
TPS25940LRVCR | U3 | WQFN-20_L4.0-W3.0-P0.50-BL-EP | C2867756
TLV6700DDCR | U4 | TSOT-23-6_L2.9-W1.6-P0.95-LS2.8-BR | C2868382
