zhuj27519-del/AirMonitor/history/stm32/AirMonitor_V2/hardware/AirMonitor_V2_P1.step

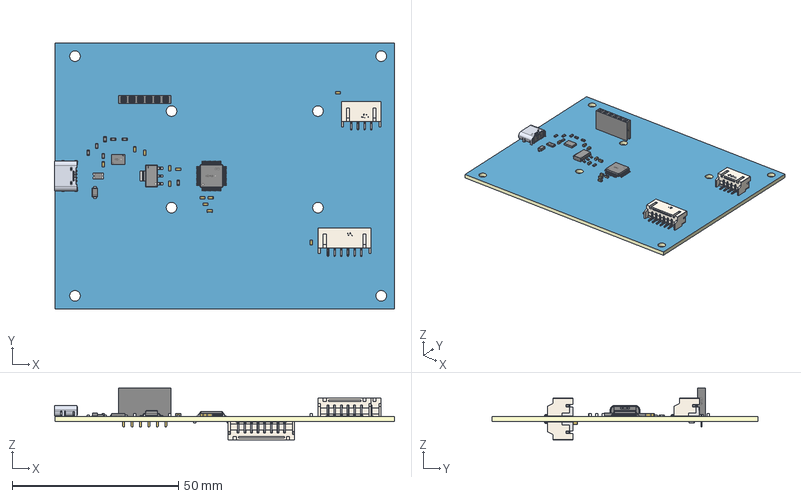
[picture p17: CAD file, 2026-11-12]
history/stm32/AirMonitor_V2/hardware/AirMonitor_V2_P1.step
102.1 x 80.0 x 15.6 mm
Board~EQ4M
TopCopper~EQ4M
BottomCopper~EQ4M
TopSilkscreen~EQ4M
BottomSilkscreen~EQ4M
TopFpcStiffener~EQ4M
BottomFpcStiffener~EQ4M
R0603~R0603~SoPM x 10
SOT-223-3_L6.7-W3.7-P2.30-LS7.0-BR~SOT-223-3_L6.7-W3.7-P2.30-LS7.0-BR~cpf6
HDR-TH_6P-P2.54-V-F~HDR-TH_6P-P2.54-V-F~7f23
SOD-123F_L2.7-W1.7-LS3.6-RD~SOD-123F_L2.7-W1.7-LS3.6-RD~c9BL
TYPE-C-SMD_TYPE-C-6P_USB4125-GF-A-0190~TYPE-C-SMD_TYPE-C-6P_USB4125-GF-A-0190~DmBJ
CONN-SMD_S6B-PH-SM4-TB-LF-SN~CONN-SMD_PH2.00-WS-6P~9Xde
C0603~C0603_L1.6-W0.8-H0.8~c5KU x 13
CONN-SMD_8P-P2.00_S8B-PH-SM4-TB-LF-SN~CONN-SMD_PH2.00-WS-8P~pTgp
F1206~F1206_L3.2-W1.7-H0.6~fzGw
CONN-SMD_S4B-PH-SM4-TB-LF-SN~CONN-SMD_PH2.00-WS-4P~dalx
WQFN-20_L4.0-W3.0-P0.50-BL-EP~WQFN-20_L4.0-W3.0-H0.8-P0.50~9d0Z
LQFP-48_L7.0-W7.0-P0.50-LS9.0-BL~LQFP-48_L7.0-W7.0-H1.4-LS9.0-P0.50~p29N
