zhuj27519-del/AirMonitor/history/hardware/KiCad-V1_5-DRAFT/AirMonitor_V1_5_Prototype_KiCad/MANUFACTURING_STATUS.txt

DESIGN DRAFT / UNSIGNED: DO NOT ORDER PCB. KiCad ERC/DRC and connector footprints must be verified. No Gerbers provided.
