zhuj27519-del/AirMonitor/history/stm32/AirMonitor_V1_first_article - fix/verification/cubeide-build-final.txt

14:27:36 **** Build of configuration Debug for project AirMonitor_V2 ****
"C:\\Users\\Peter\\miniconda3\\python.exe" build.py 
C:/ST\STM32CubeIDE_2.2.0\STM32CubeIDE\plugins\com.st.stm32cube.ide.mcu.externaltools.gnu-tools-for-stm32.14.3.rel1.win32_1.0.100.202602081740\tools\bin\arm-none-eabi-gcc.exe -mcpu=cortex-m0plus -mthumb -std=c11 -Os -g3 -Wall -Wextra -Werror -Wno-misleading-indentation -ffunction-sections -fdata-sections -DSTM32G0B1xx -Ivendor -Ivendor/CMSIS -Isrc -c src/main.c -o build/main.o
C:/ST\STM32CubeIDE_2.2.0\STM32CubeIDE\plugins\com.st.stm32cube.ide.mcu.externaltools.gnu-tools-for-stm32.14.3.rel1.win32_1.0.100.202602081740\tools\bin\arm-none-eabi-gcc.exe -mcpu=cortex-m0plus -mthumb -std=c11 -Os -g3 -Wall -Wextra -Werror -Wno-misleading-indentation -ffunction-sections -fdata-sections -DSTM32G0B1xx -Ivendor -Ivendor/CMSIS -Isrc -c src/display.c -o build/display.o
C:/ST\STM32CubeIDE_2.2.0\STM32CubeIDE\plugins\com.st.stm32cube.ide.mcu.externaltools.gnu-tools-for-stm32.14.3.rel1.win32_1.0.100.202602081740\tools\bin\arm-none-eabi-gcc.exe -mcpu=cortex-m0plus -mthumb -std=c11 -Os -g3 -Wall -Wextra -Werror -Wno-misleading-indentation -ffunction-sections -fdata-sections -DSTM32G0B1xx -Ivendor -Ivendor/CMSIS -Isrc -c src/protocol.c -o build/protocol.o
C:/ST\STM32CubeIDE_2.2.0\STM32CubeIDE\plugins\com.st.stm32cube.ide.mcu.externaltools.gnu-tools-for-stm32.14.3.rel1.win32_1.0.100.202602081740\tools\bin\arm-none-eabi-gcc.exe -mcpu=cortex-m0plus -mthumb -std=c11 -Os -g3 -Wall -Wextra -Werror -Wno-misleading-indentation -ffunction-sections -fdata-sections -DSTM32G0B1xx -Ivendor -Ivendor/CMSIS -Isrc -c src/syscalls.c -o build/syscalls.o
C:/ST\STM32CubeIDE_2.2.0\STM32CubeIDE\plugins\com.st.stm32cube.ide.mcu.externaltools.gnu-tools-for-stm32.14.3.rel1.win32_1.0.100.202602081740\tools\bin\arm-none-eabi-gcc.exe -mcpu=cortex-m0plus -mthumb -std=c11 -Os -g3 -Wall -Wextra -Werror -Wno-misleading-indentation -ffunction-sections -fdata-sections -DSTM32G0B1xx -Ivendor -Ivendor/CMSIS -Isrc -c vendor/system_stm32g0xx.c -o build/system_stm32g0xx.o
C:/ST\STM32CubeIDE_2.2.0\STM32CubeIDE\plugins\com.st.stm32cube.ide.mcu.externaltools.gnu-tools-for-stm32.14.3.rel1.win32_1.0.100.202602081740\tools\bin\arm-none-eabi-gcc.exe -mcpu=cortex-m0plus -mthumb -std=c11 -Os -g3 -Wall -Wextra -Werror -Wno-misleading-indentation -ffunction-sections -fdata-sections -DSTM32G0B1xx -Ivendor -Ivendor/CMSIS -Isrc -c vendor/startup_stm32g0b1xx.s -o build/startup_stm32g0b1xx.o
C:/ST\STM32CubeIDE_2.2.0\STM32CubeIDE\plugins\com.st.stm32cube.ide.mcu.externaltools.gnu-tools-for-stm32.14.3.rel1.win32_1.0.100.202602081740\tools\bin\arm-none-eabi-gcc.exe -mcpu=cortex-m0plus -mthumb -std=c11 -Os -g3 -Wall -Wextra -Werror -Wno-misleading-indentation -ffunction-sections -fdata-sections -DSTM32G0B1xx -Ivendor -Ivendor/CMSIS -Isrc build/main.o build/display.o build/protocol.o build/syscalls.o build/system_stm32g0xx.o build/startup_stm32g0b1xx.o -TSTM32G0B1CBTX_FLASH.ld --specs=nano.specs --specs=nosys.specs -Wl,--gc-sections,-Map=build/AirMonitor_V2.map -Wl,--no-warn-rwx-segments -o build/AirMonitor_V2.elf
C:\ST\STM32CubeIDE_2.2.0\STM32CubeIDE\plugins\com.st.stm32cube.ide.mcu.externaltools.gnu-tools-for-stm32.14.3.rel1.win32_1.0.100.202602081740\tools\bin\arm-none-eabi-objcopy.exe -O ihex build/AirMonitor_V2.elf build/AirMonitor_V2.hex
C:\ST\STM32CubeIDE_2.2.0\STM32CubeIDE\plugins\com.st.stm32cube.ide.mcu.externaltools.gnu-tools-for-stm32.14.3.rel1.win32_1.0.100.202602081740\tools\bin\arm-none-eabi-objcopy.exe -O binary build/AirMonitor_V2.elf build/AirMonitor_V2.bin
C:\ST\STM32CubeIDE_2.2.0\STM32CubeIDE\plugins\com.st.stm32cube.ide.mcu.externaltools.gnu-tools-for-stm32.14.3.rel1.win32_1.0.100.202602081740\tools\bin\arm-none-eabi-size.exe build/AirMonitor_V2.elf
   text	   data	    bss	    dec	    hex	filename
   6568	     92	   7556	  14216	   3788	build/AirMonitor_V2.elf

14:27:37 Build Finished. 0 errors, 0 warnings. (took 1s.506ms)

Saving workspace.
