zhuj27519-del/AirMonitor/history/stm32/AirMonitor_KEY3_diagnostic/manufacturing/REVIEW_ONLY.md

本目录为 KEY3 专项通过后的制造审核候选，未提交订单。不可把 KEY3/DRC 通过视为电源实测、机械实配或 SMT 贴装审核通过。详见 ../REPORT.md。
