zhuj27519-del/AirMonitor/history/stm32/AirMonitor_V1_first_article - fix/verification/v1-step-size.txt

{"ok":false,"error":{"code":"REQUEST_TIMEOUT","message":"invoke timed out after 179750ms (budget 180000ms; gave up waiting; the code may still be running in the render, and its result will be discarded)"}}
REQUEST_TIMEOUT: invoke timed out after 179750ms (budget 180000ms; gave up waiting; the code may still be running in the render, and its result will be discarded)
