zhuj27519-del/AirMonitor/docs/images/prototype-v4/side-wiring.jpg

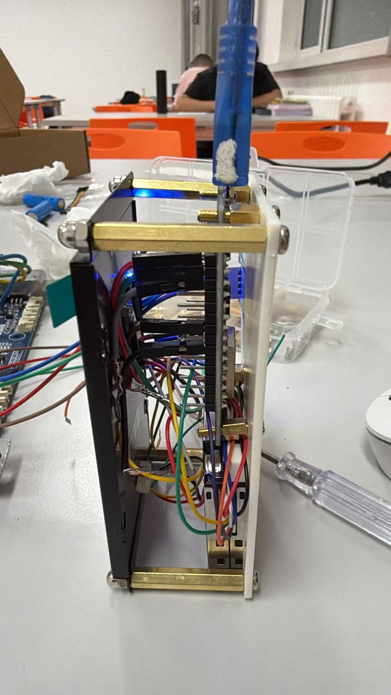
docs/images/prototype-v4/side-wiring.jpg
