zhuj27519-del/AirMonitor/history/stm32/AirMonitor_V1_first_article - fix/verification/protocol-tests-final.txt

{
  "passed": true,
  "assertions": 107,
  "method": "Actual compiled ARM C parser executed on host in Unicorn; no hardware emulation claimed"
}
