zhuj27519-del/AirMonitor/history/stm32/AirMonitor_V2/documentation/bringup.md

# 样机上电与验证计划（尚未执行）

先关闭 verification/report.md 中的制造阻塞项，再制作样机。以下是计划，不是测试通过记录。

1. 对照厂家图纸核查全部封装及装配方向，尤其 J1 USB4125 焊盘与槽孔尺寸、J2/J3/J4 锁扣与针 1、U1 的非 N 后缀引脚。核对两面的 CPL 旋转，生成装配厂预览后逐件复查。
2. 验证显示模块孔位、安装高度、插线空间、按钮可触及性。PMS 进/出风不能被主板和外壳遮挡；不要让排风回流到进风。21VOC 与 MCU、LDO、显示背光保持热距离，具体外壳结构仍未设计。
3. 断电测量 VBUS/5V/3V3 对地阻抗，检查 USB-C CC1/CC2 独立约 5.1k 下拉，无焊桥；逐根检查线束。电源空载先不接外设。
4. 使用可限流的 5 V 电源，初始较低限流，检查 3.3 V、NRST、静态电流。接通 LCD 后测最大背光电流和 LDO 温升，再接 VOC、最后接 PMS，记录每个阶段电流。
5. 在低/高输入电压及目标最高环境温度下核查电压、启动和复位。实测供电线束与保护器件压降。不要用 MCP1826S 的 1 A 额定值代替实际热能力计算。在不接传感器时先测试 eFuse 的 OVP、限流、缓启动及故障后重新上电恢复；确认最大输出电压、过冲和温漂后再连接模块。
6. 通过 SWD 读取芯片 ID，核查 option bytes：从 Flash 启动并保留 SWD，不启用读保护。烧录 firmware/build/AirMonitor_V2.elf（或 .hex），验证 SysTick、UART 波特率和 SPI Mode 0。
7. 首先用记录的 UART 帧回放验证显示，再接真实传感器。用户选择八针接口；先记录原始 UART 数据并核对 32 字节帧是否匹配现有解析器。PMS 唤醒后等待至少 30 s。拔除、插回串口，注入错误校验和、丢字节、连续帧，确认不会显示过期数值为新测量。
8. 验证 KEY1 上一页、KEY2 下一页、KEY3 诊断页及消抖。观察 UART 丢字节/错误计数；显示更新期间不应持续增加。
9. 与适当参考仪器比较，分别记录原始数据、环境温湿度、预热和采样条件。eCO2 是估算值；HCHO 属交叉敏感的传感器报告值，不能凭显示单位推断选择性或检测精度。

建议用户投入预算：资料/线束确认 2–3 h；封装及机械复核 3–4 h；EDA 修复与制造复核 3–5 h；装配及基础上电 3–4 h；协议与功能联调 3–4 h。合计约 14–20 h，不含采购运输及长期标定。
