zhuj27519-del/AirMonitor/history/stm32/AirMonitor_V1_first_article - fix/verification/remaining-errors.csv

type | net | object1 | object2 | x_mm | y_mm | primitive_ids
Connection Error | KEY3 | {'typeName': 'Track', 'suffix': '(KEY3): e1557'} |  | 40.21076413 | 39.250012940000005 | 50ed7851da96bd02
Connection Error | KEY3 | {'typeName': 'Track', 'suffix': '(KEY3): e1564'} |  | 39.7473424 | 39.17406694 | 3dc5ae6a88fe8cb1
