zhuj27519-del/AirMonitor/history/stm32/AirMonitor_V1_first_article - fix/README.md

# AirMonitor V2 — V1 首版交付

**NO-GO（存在未关闭生产阻断项）。整机安全上电未验证，直接 SMT 订单未放行。**

先阅读 [最终报告](FINAL_REPORT.md)。制造文件在 manufacturing/；完整可编辑工程位于 hardware/EasyEDA/AirMonitor V1 - First Article.eprj3，必须保留相邻目录。firmware/ 为冻结的 P1 固件；verification/ 保存实际检查证据。PCB 预览的背面图是从顶面观察底层，未镜像。

本包已结束设计迭代。未下单、未上传、未实测上电。
