zhuj27519-del/AirMonitor/TODO.md

# 后续任务

- [x] 搜索 C/D 磁盘可读取目录；识别源码、硬件与历史包
- [x] 原件保留，按 SHA-256 验证复制并建立目录与版本记录
- [x] ESP8266/HF035 主源码编译成功
- [ ] 确认实物为裸 ESP-12F 还是 NodeMCU；核对启动与供电电路
- [ ] 捕获 PMS7003M/21VOC 真实 UART 帧，确认模块型号、单位、校验、负温度编码
- [ ] 检查 PMS 错误状态字与噪声重同步；确认丢帧、断连、过期及 millis 回绕行为
- [ ] 核对 HF035 屏端输入方向、sGUI 工程控件 ID 0..8 和显示单位
- [ ] 测试两个软件串口同时接收时丢帧率；评估 IRAM 94% 的余量
- [ ] 完成 OLED 历史版与 STM32 分支的独立回归（本次主编译不覆盖它们）
- [ ] 按各历史 NO-GO 报告关闭电源、连接器、封装与制造验收项
- [x] GitHub 账户授权、Private 仓库创建、首次 push 与远端 SHA 校验

- [x] 收录四张用户提供的 V4 原型机照片，添加首页展示与装配说明
- [ ] 确认实拍日期、对应硬件版本及烧录固件提交号
- [ ] 核对照片中 Humidity 单位疑似 ppm 的问题，将界面相对湿度单位修正为 %RH
- [ ] 检查原型机外露线端绝缘、线缆固定及应力释放

- [x] 按用户后续要求将 GitHub 仓库改为 Public，并验证匿名页面及提交访问
