zhuj27519-del/AirMonitor/history/stm32/AirMonitor_V1_first_article - fix/documentation/interfaces.md

# AirMonitor V2 — V1 — 接线与接口约定

状态：冻结首版；制造/上电放行范围以 FINAL_REPORT.md 为准。引脚编号以元件本体/厂家图纸为准；不能凭线色、照片朝向或“直通线”名称接线。

## MCU

STM32G0B1CBT6，LQFP48，非 N 后缀变体。使用内部 HSI16、3.3 V。固件启动后保持 SWD 引脚功能。

| 功能 | MCU 引脚 | 封装脚号 | 外设 |
|---|---|---:|---|
| PMS 主机发送 / 接收 | PA9 / PA10 | 29 / 32 | USART1 AF1，9600 8N1 |
| VOC 主机发送 / 接收 | PA2 / PA3 | 13 / 14 | USART2 AF1，9600 8N1 |
| LCD SCK / MOSI | PA5 / PA7 | 16 / 18 | SPI1 AF0，Mode 0，2 MHz |
| LCD CS / DC / RST / BL | PA4 / PB0 / PB1 / PB2 | 15 / 19 / 20 / 21 | GPIO |
| PMS SET / RESET | PB10 / PB11 | 22 / 23 | GPIO，正常工作输出高 |
| KEY1 / KEY2 / KEY3 | PB3 / PB4 / PB5 | 42 / 43 / 44 | 低有效，10k 上拉 |
| SWDIO / SWCLK / NRST | PA13 / PA14 / PF2 | 35 / 36 / 10 | 调试 / 复位 |

U1 的 4=VBAT、5=VREF+、6=VDD/VDDA 接 3V3，7=VSS 接地；不要套用其他封装或带 N 后缀变体的电源脚。

## J2 — PMS 主板线束（JST PH 6 针）

| J2 脚 | 主板网络 | 传感器方向 |
|---:|---|---|
| 1 | 5V | 供电 |
| 2 | GND | 地 |
| 3 | PMS_RX | 传感器 TX → MCU RX |
| 4 | PMS_TX | MCU TX → 传感器 RX |
| 5 | PMS_SET | 主机控制 |
| 6 | PMS_RST | 主机控制 |

用户已确认使用商品图中的八针传感器接口。主板 J2 的 1、2、3、4、5、6 分别连接传感器 1、2、5、4、3、6，传感器 7/8 悬空。主板 J2 为自定义 PH 六针接口，必须使用转接线束。完整针号和图片证据见 [传感器线束表](sensor-harness-options.md)。传感器端使用该模块配套八针线，不凭照片推定插头型号；制作前确认 Pin 1 并逐线导通测试。

## J3 — 21VOC（JST PH 4 针）

| J3 脚 | 主板网络 | 用户提供的 21VOC 脚 |
|---:|---|---|
| 1 | 3V3 | 1 VCC |
| 2 | VOC_RX | 2 TXD |
| 3 | VOC_TX | 3 RXD |
| 4 | GND | 4 GND |

用户资料确认 3.3 V、功耗 <40 mW、模块约 18×15×3 mm；资料中侧面端子为 2 mm，另处提及 2.54 mm 引脚。主板 PH 连接器仅作为线束端，不声称与传感器连接器直接机械配合。需确认传感器实际连接器系列、锁扣和针 1。

## J4 — Waveshare 18079，1.54inch LCD Module

选择 ST7789、240×240、50×35 mm 成品模块，以 3.3 V 供电。主板 J4 在背面。厂家原理图包含两种端口，**PH 电缆端 J2 的针序与另一排针 J1 方向相反**：

| 主板 J4 | 信号 | 显示模块排针 J1 | 显示模块 PH J2 |
|---:|---|---:|---:|
| 1 | 3V3/VCC | 1 | 8 |
| 2 | GND | 2 | 7 |
| 3 | MOSI/DIN | 3 | 6 |
| 4 | SCK/CLK | 4 | 5 |
| 5 | CS | 5 | 4 |
| 6 | DC | 6 | 3 |
| 7 | RST | 7 | 2 |
| 8 | BL | 8 | 1 |

按信号逐根导通检查。BL 经过模块上的晶体管驱动，MCU 不直接承受 LED 电流。厂家公开资料未给出本模块可靠的最大背光电流，电源热设计仍需实测。已依据官方尺寸图加入 44×29 mm 中心距的四个安装孔，主板孔径 3.2 mm，拟用 M2.5 尼龙支柱。8 mm 高度为样机装配建议，仍需模块、线缆和外壳实物试装。

## J5 — 自定义 SWD，1×6、2.54 mm

1=3V3 电压参考，2=SWDIO，3=GND，4=SWCLK，5=NRST，6=GND。不是标准 ARM 10 针接口。调试器应读取目标板电压，默认由 USB 给目标板供电；不要同时由调试器强行供电。

## USB-C

仅 5 V 电源输入。CC1、CC2 分别独立 5.1k 下拉。D+/D−、SBU 未使用，不进行 USB 数据枚举或 PD 协商。使用明确能提供足够 5 V 电流的电源；不得将任意 USB 主机端口都当成可提供 500 mA 的电源。

接口保护：USB4125 六针电源型 USB-C，VBUS → F1 → 5V_FUSED → TPS25940L → 5V；TVS 在 F1 后，MCP1826S 输出 3V3。电子限流典型约 0.58 A，独立过压关断名义约 5.36 V。过载/过热锁断后需要重新上电。阈值温漂、输入瞬态和实测热性能尚未完成验收，详见 power-and-layout-review.md。
