zhuj27519-del/AirMonitor/history/stm32/AirMonitor_V1_first_article - fix/documentation/power-and-layout-review.md

# 冻结电源审查索引

以 [最终冻结报告](../FINAL_REPORT.md) 为准。静态阈值计算见 [P2 电源角落计算](../verification/p2-power-corners.json)，电源线宽和位置见 [连接及线宽审计](../verification/v1-connection-and-width-audit.json)。

未完成保护动态、满载温升、外设浪涌和实物安全上电验证。当前 KEY3 仍有 DRC 错误，不予生产放行。
