zhuj27519-del/AirMonitor/history/stm32/AirMonitor_V1_first_article - fix/documentation/sensor-harness-options.md

# 颗粒物传感器线束：用户确认八针接口

2026-10-27 收到用户商品截图，已保存为 `datasheets/User_PMS_8pin_interface.jpg`。图中是八针接口，电路标注 PMS1003/3003/5003；不能将它当作 PMS7003M 的十针接口定义。

用户随后明确回复“就是这个接口”，因此本版采用图片中的八针接口。无需再等待型号确认才整理接线。另取得标题明确写有 **PMS7003M、V2.5、2016-07-02** 的攀藤手册镜像，保存为 `datasheets/Plantower_PMS7003M_V2_5.pdf`；其十针接口仅保留作差异参考，不用于本次线束。来源：[镜像资料页](https://pdf.elecfans.com/p/7222689.html)。

主板 J2 保持六路通用主机信号，因此两种方案均无需改变主板连接，仅线束不同。

| 主板 J2 | 主板信号 | 用户截图的八针传感器端 | PMS7003M V2.5 十针传感器端 |
|---|---|---|---|
| 1 | 5V | 1 VCC | 1、2 VCC，两脚均连接 |
| 2 | GND | 2 GND | 3、4 GND，两脚均连接 |
| 3 | PMS_RX，MCU 接收 | 5 TXD | 9 TX |
| 4 | PMS_TX，MCU 发送 | 4 RXD | 7 RX |
| 5 | PMS_SET | 3 SET | 10 SET |
| 6 | PMS_RST | 6 RESET | 5 RESET |
| — | 不连接 | 7、8 NC | 6、8 NC |

**不能使用同一根按针号直连的线束替代两种方案。** 不按线色判断针号。必须以插头配合面和原图的 Pin 1 标识确认方向，并在连接主板之前对每根线做通断测试。图片底部文字存在将 PIN6 写作调试针的矛盾，八针方案应以清晰的管脚表和接线图为依据；若最终实物资料也冲突，则停止接电核对。

传感器端插头的厂商料号和针距不能从这张商品图可靠确定，暂不批准替代插头。主板侧采用 JST PHR-6。准确传感器端配套线应由对应模块供应商提供或依据实物插座规格选型。

固件目前实现 PMS7003M V2.5 的 32 字节帧：头 42 4D、长度 28、16 位累加校验、取大气环境字段，版本/错误字段位置已核对。八针接口确认不等于协议确认。首次上电应录取实际 UART 帧核验长度、字段和校验，必要时调整解析器；主机测试不代替实物串口验证。
