zhuj27519-del/AirMonitor/history/stm32/AirMonitor_V2/documentation/engineering-log.md

# 工程日志 — V2-P0 / V2-P1

2026-10-26，按工作阶段记录。本日志说明设计决策与检查边界，不把失败调用当作完成结果。

1. 检查 Windows、本地 EasyEDA Pro 4.1.78、官方 AI CLI 文档及 API/格式参考。通过官方 CLI 驱动桌面编辑器并保存 JSON 证据；使用独立工程目录。V1.5 资料仅作参考，未将旧设计视为已验证。
2. 读取用户 `21voc` 目录资料并保存到交付包；核对 3.3V、功耗、12 字节串口协议与负温度编码。用户授权自主选择显示屏，选定 Waveshare 18079，读取原厂模块原理图。特别记录其 PH 插座与 8 针排针的针号方向不同。
3. 选择 STM32G0B1CBT6、AP2112K-3.3、USB4105 与 JST PH 接口。建立引脚计划，放置 29 个板上器件，加入复位、CC 下拉、退耦、电源和用户按键，未用引脚显式处理。
4. 导入 PCB，放置前面主控/电源/传感器接口、背面 LCD 接口与三个按键、四个板安装孔。根据 USB 图纸将左边界外扩 2mm，得到 102×80mm 外形。LCD 外形仅为文档层占位，没有编造安装孔尺寸。
5. 运行原生布线并处理位置/退耦调整。部分路由调用超时但后台继续，随后保存、关闭、重新打开交付副本并重新检查，以落盘数据为准。外部 Freerouting 尝试未形成最终结果，未将其路线导入作为交付版本。
6. 原理图页面边界属性修复后重新打开，最终 ERC 为 0。PCB 最终 DRC 保留 4 项 USB 焊盘到定位孔间距错误；连接类错误未报告。独立网表比对全部 147 个符号引脚通过；官方单独网表比较 API 返回异常空 PCB 侧，未声称其通过。
7. 创建两层 GND 边界，官方填铜 API 报错；填充查询为空，Gerber 无填充区域。尝试应用控制回退时授权超时，未执行 GUI 操作。本版明确记录地平面未完成。
8. 完成寄存器/CMSIS 固件、UART 接收缓冲、两种协议校验、ST7789 页面及按键逻辑。配置 CubeIDE 外部构建器；修复 CDT 项目处理指令及链接所需系统调用后，最终构建 0 错误/0 警告。107 项主机协议断言通过；无硬件测试。
9. 从最终工程导出 Gerber、钻孔、BOM、CPL、原理图/PCB PNG 与 STEP，保存原始证据。完成电源/布局审查：保护协调、热设计、封装与模块机械问题继续作为禁止制造条件。
10. 整理交付说明、验收矩阵、来源、接口和上电计划；保存/关闭临时 CLI 会话，校验交付文件，创建 Git 审查快照、SHA-256 清单与交付归档。

## 工具故障与未完成项的区分

- CLI 调用失败、导出超时、历史 ERC/DRC 结果均保留在 `verification/`；只以 `report.md` 指定的最终证据判定当前状态。
- 曾出现命令自动审批传输/额度错误；重试允许后完成了不受影响的工作，没有通过其他入口绕过拒绝。
- GUI 应用控制授权超时与填铜 API 异常是已观察到的工具阻碍。USB 封装、电源保护和模块机械审查则是未完成工程工作，不能归因于“软件检查已经通过”。
- 不存在真实硬件电源、显示、通信或热性能验证；测试清单是后续计划，不是测试报告。

Git 本版提交固定当前审查状态。之后任何封装、电源或填铜变更都必须更新原生工程并重新运行相关验证和制造导出。

## 2026-10-27 — P1 修订

用户要求继续解决四项 USB 间距错误、地铜、电源、封装、线束和机械问题。改用 USB4125、MCP1826S，新增 TPS25940L 及分压/限流/缓启动器件，共 37 个器件。TVS 移到 PTC 后。按官方 LCD 图纸加入 44×29mm 孔位，移动 J3/J5 清避安装孔。重新布线并设置主电源 0.5mm，允许细间距引脚局部缩颈。

修复地铜边界坐标，GUI 补铜成功；重新布线后的后台停滞通过保存、关闭本任务会话、重开后单独补铜解决。物理叠层由 GUI 检查并保存。原理图 Channel ID 属性与 PCB 不一致，电气引脚网表一致；原生同步变更后重开检查通过。

发现组件子焊盘 setter 修改未跨重开保留；依据官方原生格式持久化 USB 两个电源铜盘宽度及 U2/U3 地散热盘直连设置。再次重开、读回、补铜和 DRC。最终 2 个铜面、DRC 0、ERC 0，168 个引脚和 139 个预定连接独立比对一致。保存后的路由为 433 段、38 过孔。

用户提供八针模块图并回复“就是这个接口”；因此线束按该八针接口完成，不再把 PMS7003M 的十针资料强加给实际模块。32 字节固件协议与 PMS7003M V2.5 手册核对，但八针实物帧仍需上电验证。

OVP 公差计算揭示上限余量仅 2.2mV，未把典型阈值写作保证值。完整封装/钢网、温升、模块实际线束与机械试装仍未验收。重导出 P1 全套文件，P0 ZIP/Git 历史保留，不下单、不上传制造数据。
