zhuj27519-del/AirMonitor/history/stm32/AirMonitor_V2/documentation/footprint-review.md

# P1 封装与装配复核记录

2026-10-27。本表区分已核对尺寸、库封装差异和仍需装配验收的项目；DRC 通过不代替封装验收。

| 对象 | 已检查 / 修订 | 剩余验收 |
|---|---|---|
| J1 USB4125-GF-A-0190 | 采用 GCT A6 图纸；A9/B9 铜盘改为 0.76×1.20mm，CC 铜盘 0.70×1.20mm，GND 铜盘 0.80×1.20mm；壳脚槽 0.60×1.20mm，壳脚盘约 1.10×1.70mm；无原 USB4105 的 NPTH 定位孔冲突；板边对齐插口前缘；1.90mm 壳脚选项 | 装配厂钢网与插座实物配合、板边公差和壳体开口 |
| U2 MCP1826S | IN1、GND2、OUT3、GND tab4 核对；SOT-223 地散热盘设为直连，两侧邻近地过孔；4.7µF 输入/输出电容 | 完整封装尺寸叠图、焊膏覆盖率、两层板实际热阻 |
| U3 TPS25940L | 20 个外围脚和 EP21 分网核对；EP 铜盘约 2.60×1.60mm，0.50mm 引脚节距，与 TI RVC 图纸一致；EP 直连地铜，采用相邻过孔 | 当前库外围盘约 0.30×0.90mm，TI 示例为 0.20×0.60mm，库焊盘中心距也采用不同外扩量；需装配厂确认 IPC 焊盘方案或采用厂家示例重做并重新验证。当前不称为完整厂家推荐封装 |
| U1 STM32G0B1CBT6 | LQFP48 非 N 后缀电源、复位、SWD 和复用功能脚已核对 | 逐尺寸制造图叠图及 CPL 的 pin1/旋转终审 |
| J2/J3/J4 JST PH | 2mm 节距；分别为 6/4/8 针侧插 SMT，J4 背面；按编号逐针比对网表；主板端 PHR 壳体选型明确 | 安装锚脚焊盘与 JST 具体型号图纸完整叠图，锁扣/插线空间、底面装配朝向 |
| F1、D1 | PTC 已在 TVS 上游；TVS cathode1=5V_FUSED，anode2=GND | 厂家封装尺寸、丝印极性标记、实际能量额定值 |
| R/C、按键和 J5 | 数值、网名、数量、正背面和几何 DRC 已检查；J5 为 2.54mm 通孔件 | 0603 元件额定值/有效容量、按键高度/手感、J5 手焊工序和整体装配厂审核 |
| LCD | 官方 50×35mm 外形、44×29mm 孔中心距；主板 4×Ø3.2mm 孔；M2.5 尼龙支柱方案 | 8mm 支柱高度建议、真实显示模块版本、线缆转弯、外壳和按钮碰撞试装 |

官方 API 的组件子焊盘 setter 曾显示成功但重开后回退。最终通过官方原生 TPcbPad / EPadConnect 格式，在工程内嵌封装资源中持久化两个 USB 铜盘宽度和两个散热盘直连设置。两份原生文档均同步修改，重开读回和保存后的文件检查通过，见 `verification/p1-native-footprint-edits.json`、`p1-native-readback.json`。没有修改供应商云库，也未降低 DRC 间距。

库中的部分焊盘关闭了自动钢网扩展并使用独立助焊层图形。最终钢网开口必须按导出的 Paste 层复核，尤其 QFN EP；不能仅看焊盘 expansion 数字判定有无焊膏。此项尚未获得装配厂确认。
