zhuj27519-del/AirMonitor/history/stm32/AirMonitor_KEY3_diagnostic/README.md

# KEY3 专项诊断与制造审核候选

先阅读 [简短报告](REPORT.md)。KEY3 连通、完整 DRC 0 错误；可进入下一轮制造审核，尚非整机上电或 SMT 生产放行。没有进行电路修复；本包工程为已核验副本。原始冻结交付包未改动。
