zhuj27519-del/AirMonitor/history/stm32/AirMonitor_V1_first_article - fix/verification/v1-last-connection-fix.txt

{"ok":true,"value":{"key3_via_mm":[39.6713964,39.25001294],"trunk":"a0a50906f2a82645","old_width_mm":0.20015200000000002,"new_width_mm":0.5},"logs":[],"durationMs":1746}
