zhuj27519-del/AirMonitor/history/stm32/AirMonitor_V1_first_article - fix/datasheets/User_PMS_8pin_interface.jpg

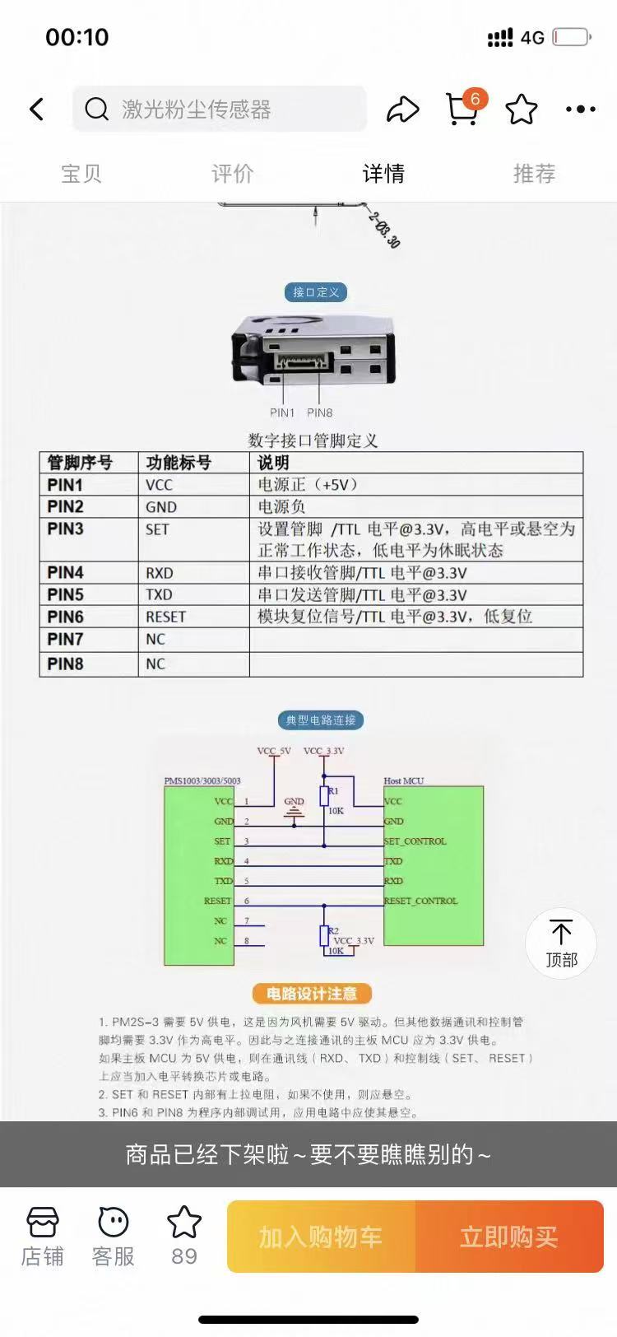
history/stm32/AirMonitor_V1_first_article - fix/datasheets/User_PMS_8pin_interface.jpg
