zhuj27519-del/AirMonitor/history/stm32/AirMonitor_V1_first_article - fix/datasheets/Waveshare_18079_dimensions.jpg

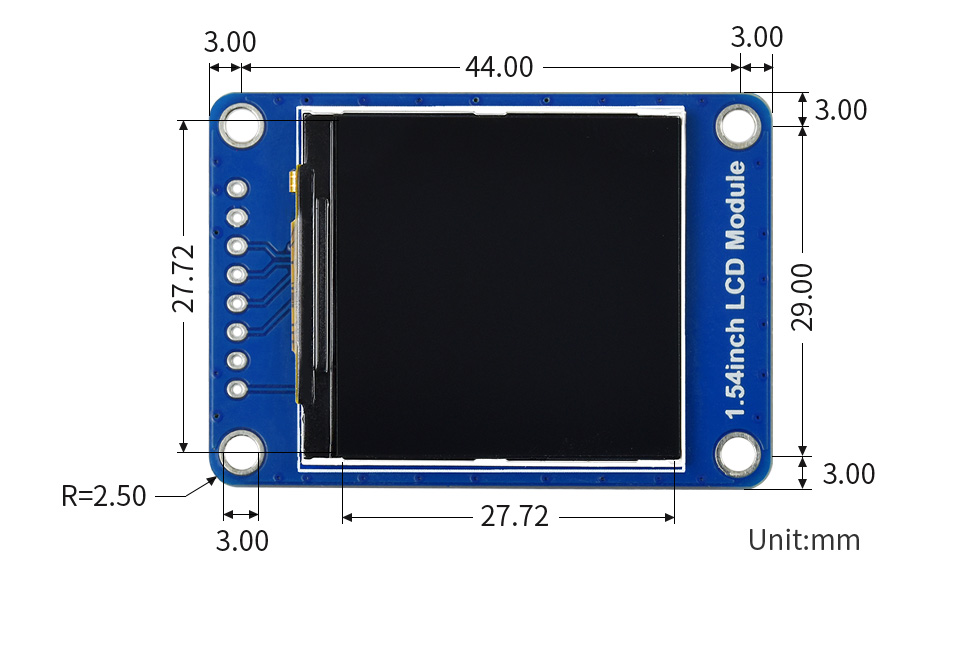
history/stm32/AirMonitor_V1_first_article - fix/datasheets/Waveshare_18079_dimensions.jpg
