zhuj27519-del/AirMonitor/history/hardware/KiCad-V1_5-DRAFT/AirMonitor_V1_5_Prototype_KiCad/AirMonitor_V1_5.kicad_pcb

## KiCad design history/hardware/KiCad-V1_5-DRAFT/AirMonitor_V1_5_Prototype_KiCad/AirMonitor_V1_5.kicad_pcb (2026-11-12)

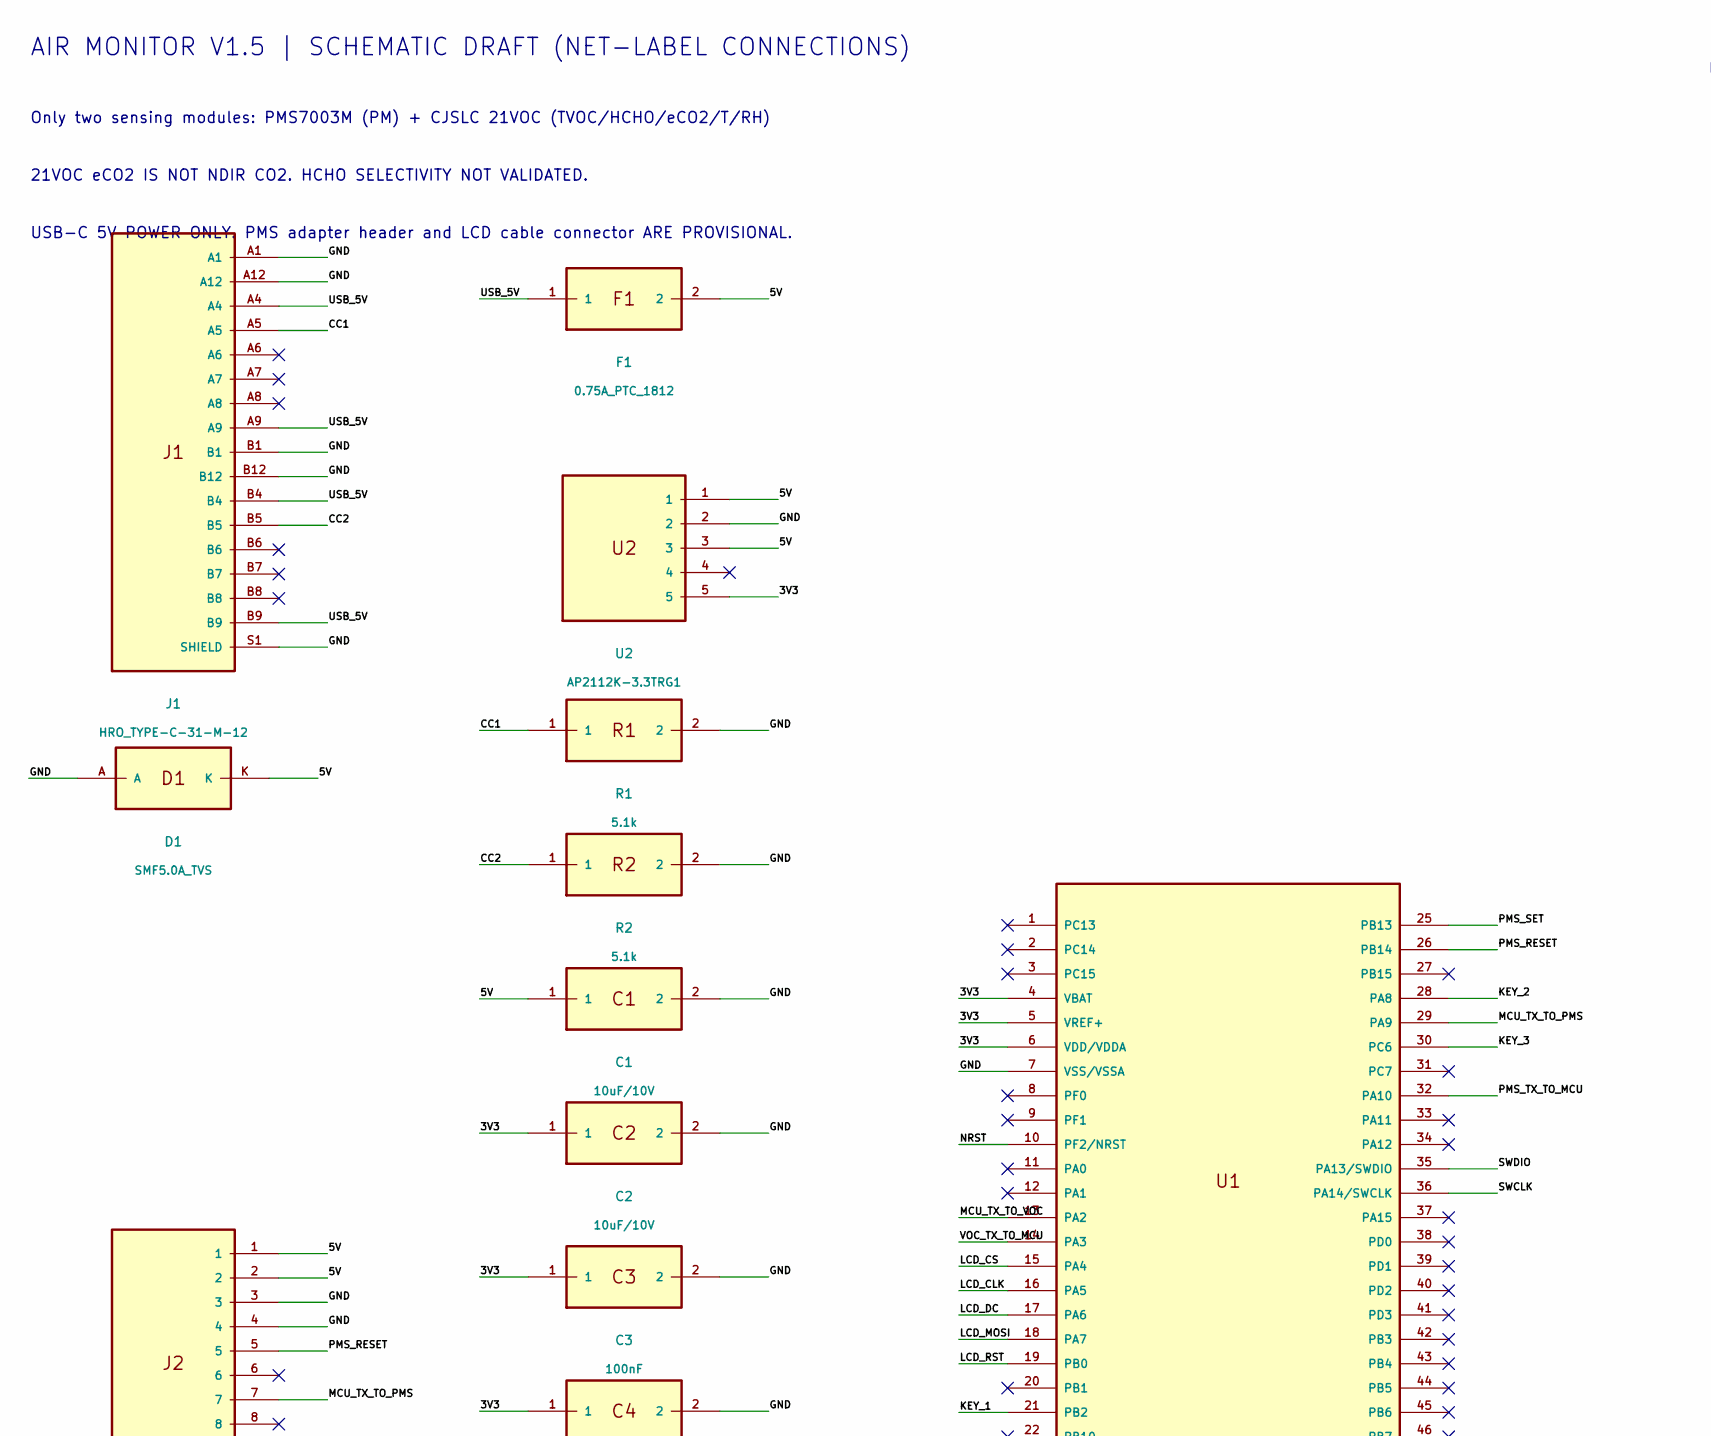
[picture p21: schematic AirMonitor_V1_5.kicad_sch, Air Monitor V1.5 - ROUTED-DRAFT, part in row 1, column 1]

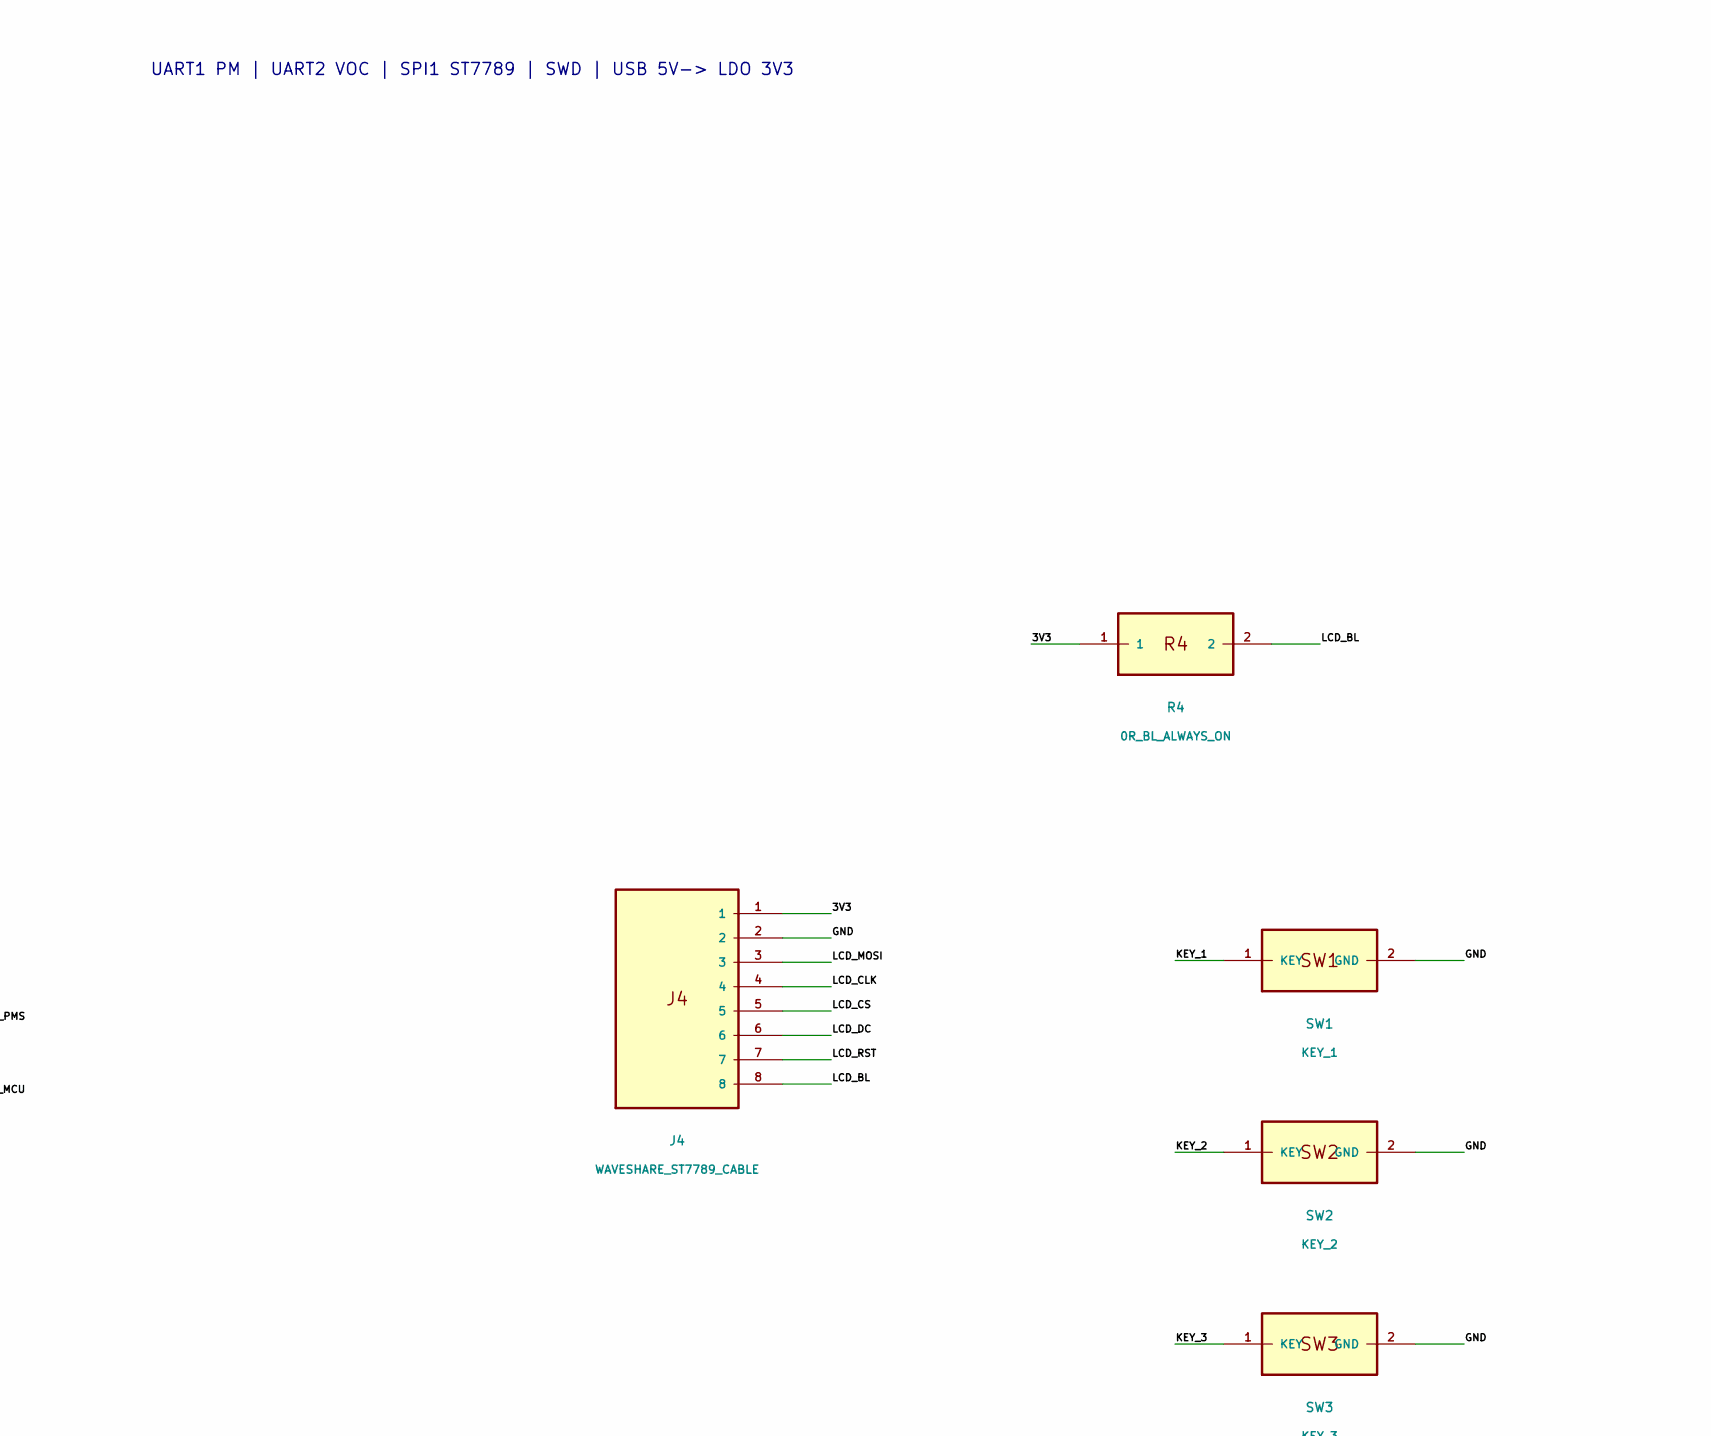
[picture p22: schematic AirMonitor_V1_5.kicad_sch, Air Monitor V1.5 - ROUTED-DRAFT, part in row 1, column 2]

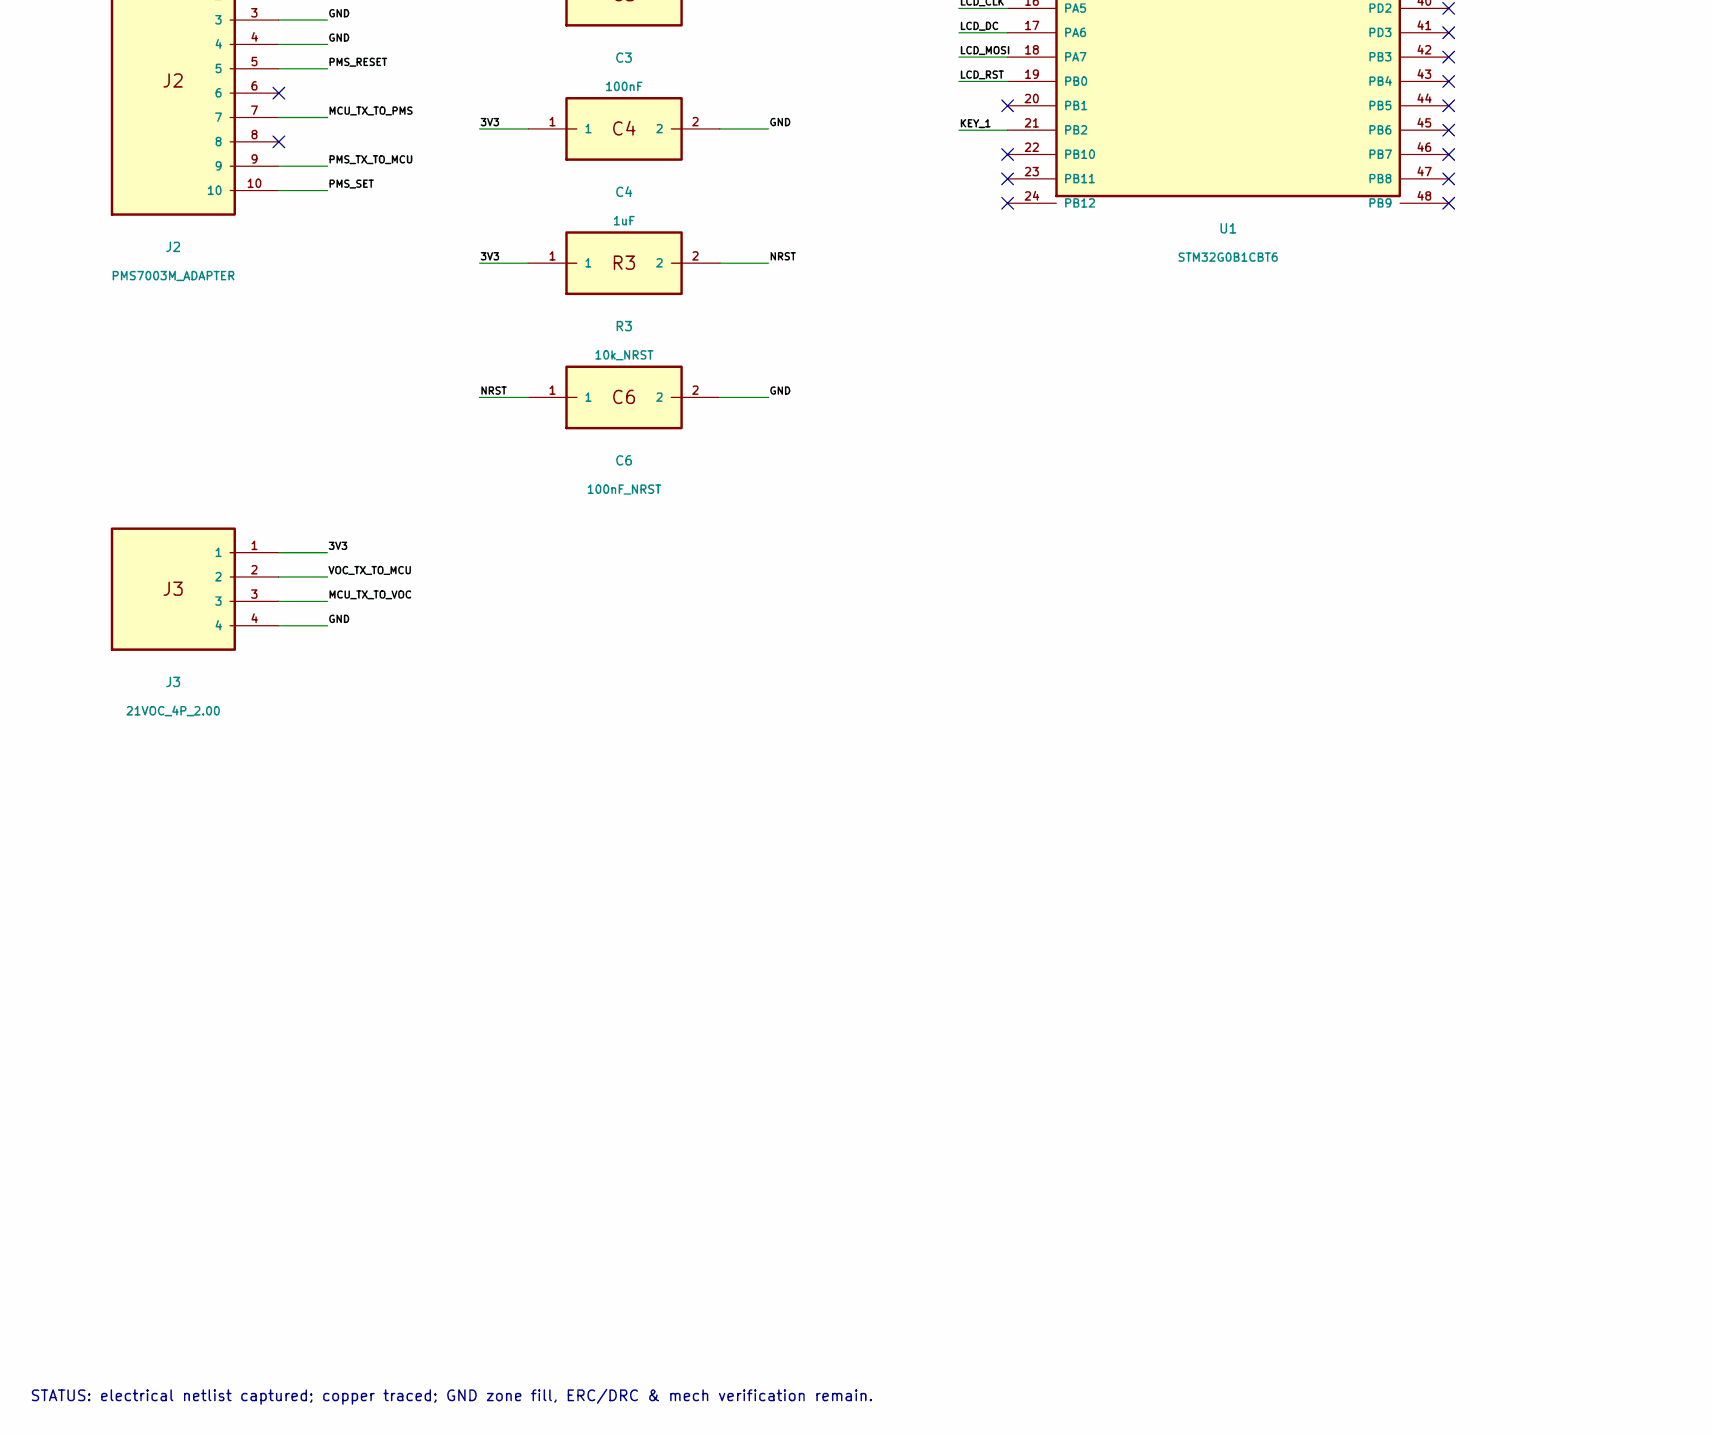
[picture p23: schematic AirMonitor_V1_5.kicad_sch, Air Monitor V1.5 - ROUTED-DRAFT, part in row 2, column 1]

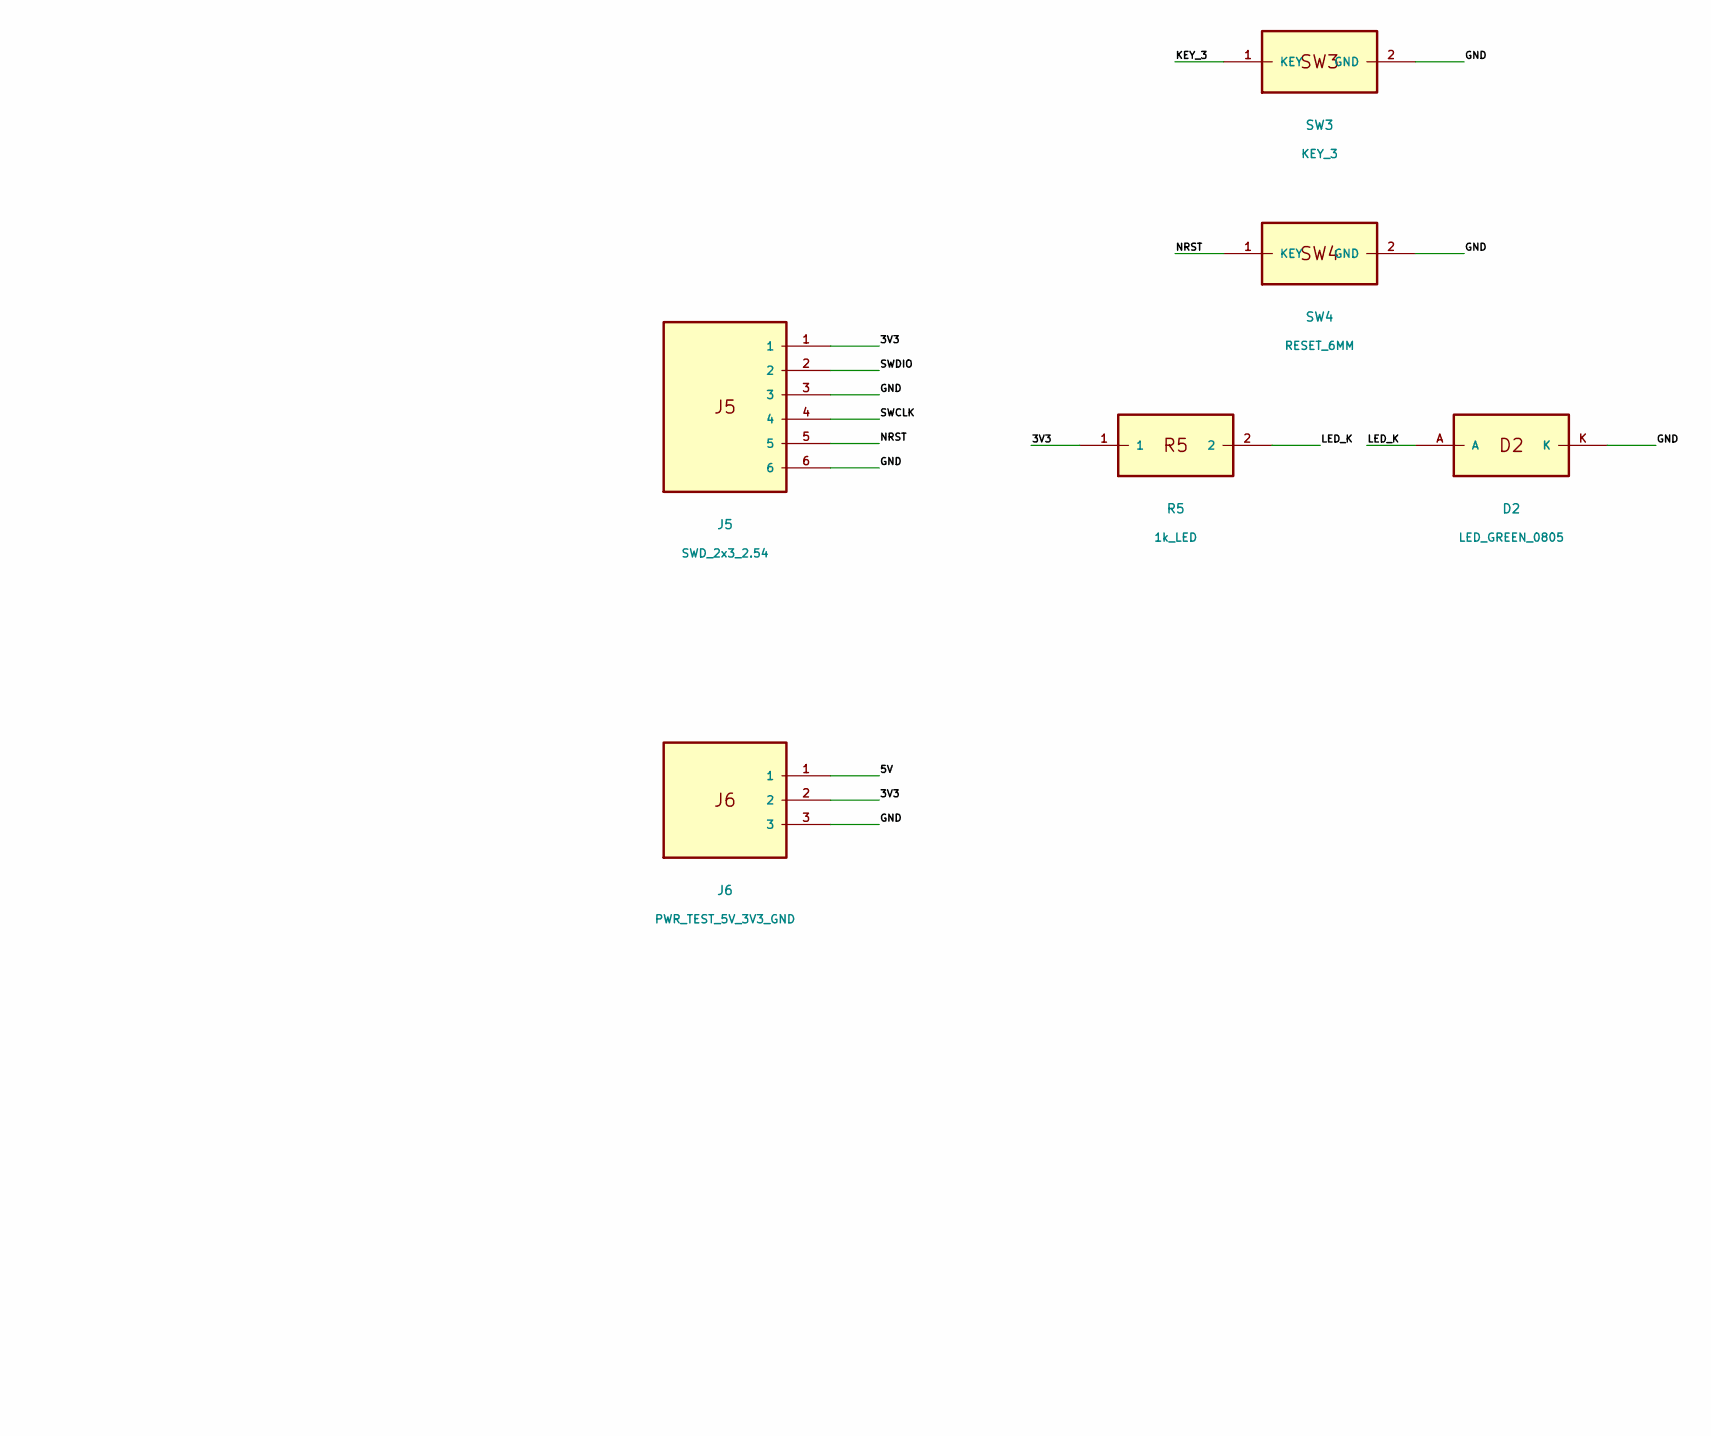
[picture p24: schematic AirMonitor_V1_5.kicad_sch, Air Monitor V1.5 - ROUTED-DRAFT, part in row 2, column 2]

Parts:
C1, C2: 10uF/10V; 0805
C3: 100nF; 0805
C4: 1uF; 0805
C6: 100nF_NRST; 0805
D1: SMF5.0A_TVS; SOD123
D2: LED_GREEN_0805; LED_0805
F1: 0.75A_PTC_1812; 1812
J1: HRO_TYPE-C-31-M-12; USB_C_HRO
J2: PMS7003M_ADAPTER; PinHeader_2x05_2.54
J3: 21VOC_4P_2.00; PinHeader_1x04_2.00
J4: WAVESHARE_ST7789_CABLE; PinHeader_1x08_2.00
J5: SWD_2x3_2.54; PinHeader_2x03_2.54
J6: PWR_TEST_5V_3V3_GND; PinHeader_1x03_2.54
R1, R2: 5.1k; 0805
R3: 10k_NRST; 0805
R4: 0R_BL_ALWAYS_ON; 0805
R5: 1k_LED; 0805
SW1: KEY_1; SW_6x6mm_THT
SW2: KEY_2; SW_6x6mm_THT
SW3: KEY_3; SW_6x6mm_THT
SW4: RESET_6MM; SW_6x6mm_THT
U1: STM32G0B1CBT6; LQFP48_7x7_P0.5
U2: AP2112K-3.3TRG1; SOT23_5

Connections:
3V3: C2.1, C3.1, C4.1, J3.1, J4.1, J5.1, J6.2, R3.1, R4.1, R5.1, U1.4 (VBAT), U1.5 (VREF+), U1.6 (VDD/VDDA), U2.5
5V: C1.1, D1.K, F1.2, J2.1, J2.2, J6.1, U2.1, U2.3
CC1: J1.A5, R1.1
CC2: J1.B5, R2.1
GND: C1.2, C2.2, C3.2, C4.2, C6.2, D1.A, D2.K, J1.A1, J1.A12, J1.B1, J1.B12, J1.S1 (SHIELD), J2.3, J2.4, J3.4, J4.2, J5.3, J5.6, J6.3, R1.2, R2.2, SW1.2 (GND), SW2.2 (GND), SW3.2 (GND), SW4.2 (GND), U1.7 (VSS/VSSA), U2.2
KEY_1: SW1.1 (KEY), U1.21 (PB2)
KEY_2: SW2.1 (KEY), U1.28 (PA8)
KEY_3: SW3.1 (KEY), U1.30 (PC6)
LCD_BL: J4.8, R4.2
LCD_CLK: J4.4, U1.16 (PA5)
LCD_CS: J4.5, U1.15 (PA4)
LCD_DC: J4.6, U1.17 (PA6)
LCD_MOSI: J4.3, U1.18 (PA7)
LCD_RST: J4.7, U1.19 (PB0)
LED_K: D2.A, R5.2
MCU_TX_TO_PMS: J2.7, U1.29 (PA9)
MCU_TX_TO_VOC: J3.3, U1.13 (PA2)
NRST: C6.1, J5.5, R3.2, SW4.1 (KEY), U1.10 (PF2/NRST)
PMS_RESET: J2.5, U1.26 (PB14)
PMS_SET: J2.10, U1.25 (PB13)
PMS_TX_TO_MCU: J2.9, U1.32 (PA10)
SWCLK: J5.4, U1.36 (PA14/SWCLK)
SWDIO: J5.2, U1.35 (PA13/SWDIO)
USB_5V: F1.1, J1.A4, J1.A9, J1.B4, J1.B9
VOC_TX_TO_MCU: J3.2, U1.14 (PA3)

Notes on the sheet:
AIR MONITOR V1.5 | SCHEMATIC DRAFT (NET-LABEL CONNECTIONS)
Only two sensing modules: PMS7003M (PM) + CJSLC 21VOC (TVOC/HCHO/eCO2/T/RH)
21VOC eCO2 IS NOT NDIR CO2. HCHO SELECTIVITY NOT VALIDATED.
USB-C 5V POWER ONLY. PMS adapter header and LCD cable connector ARE PROVISIONAL.
STATUS: electrical netlist captured; copper traced; GND zone fill, ERC/DRC & mech verification remain.
UART1 PM | UART2 VOC | SPI1 ST7789 | SWD | USB 5V-> LDO 3V3

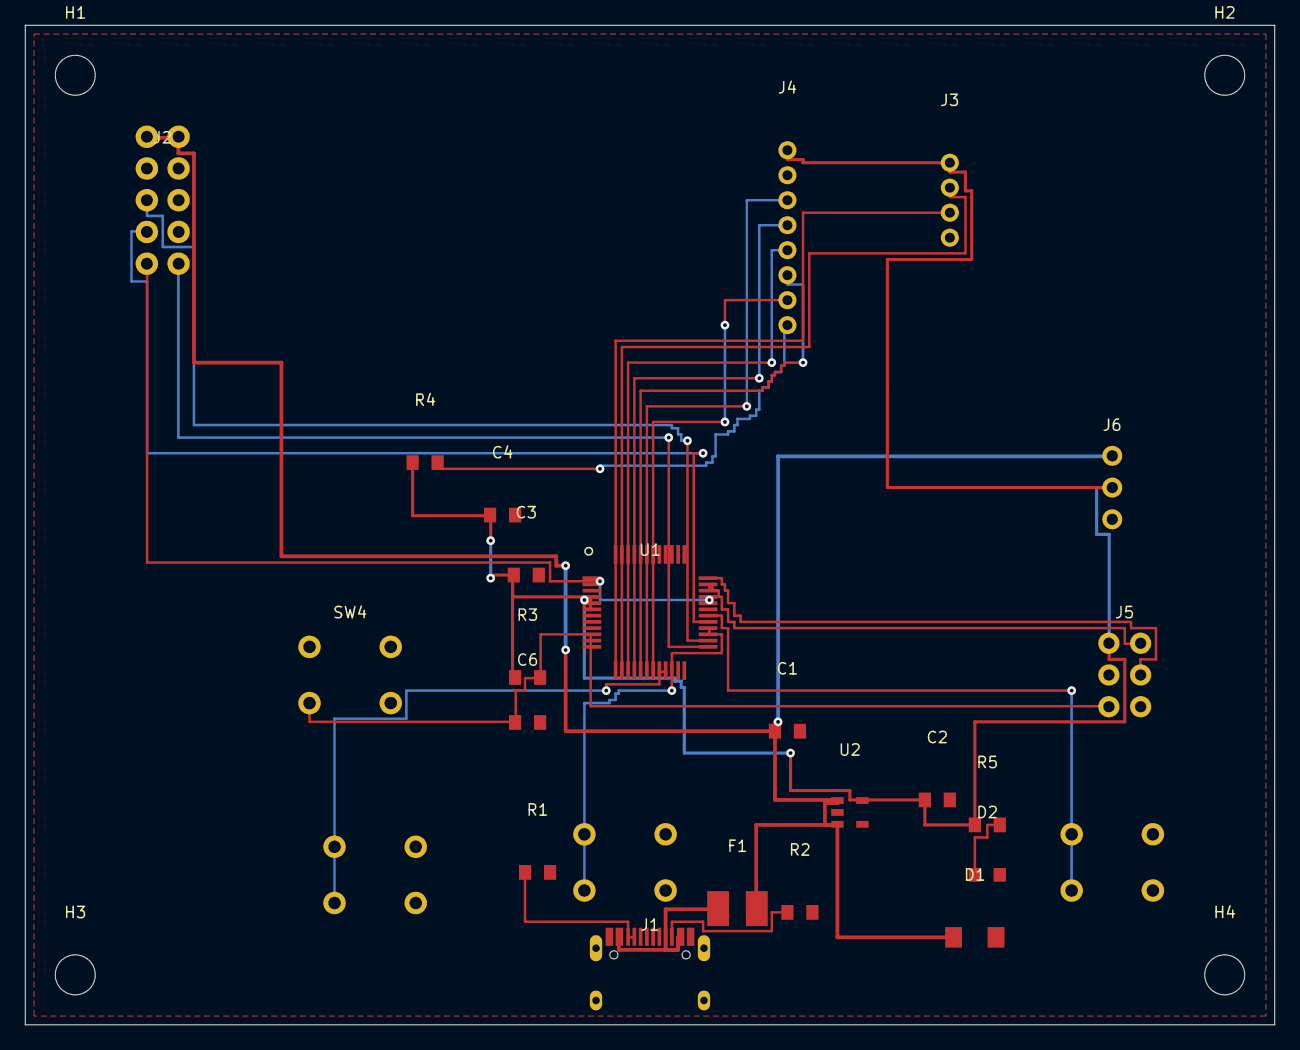
[picture p25: board AirMonitor_V1_5.kicad_pcb from above]

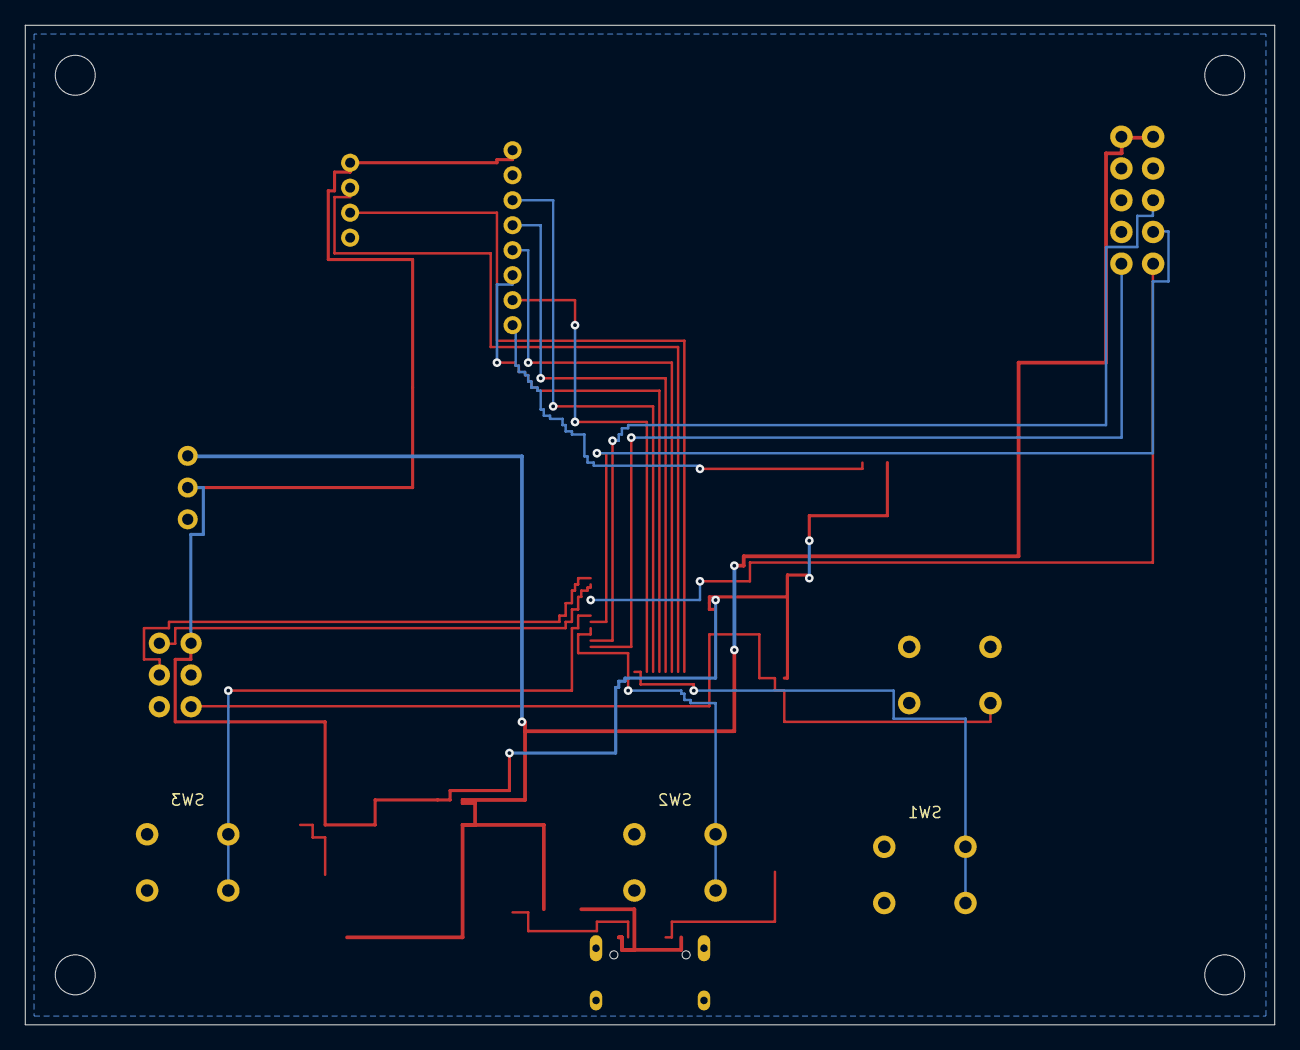
[picture p26: board AirMonitor_V1_5.kicad_pcb from below]

Board: 2 copper layers, 100.0 x 80.0 mm, 29 parts (3 on the bottom side), 25 nets.

Other parts of the board:
H1, H2, H3, H4: M3_NPTH; MountingHole_3.2
