zhuj27519-del/AirMonitor/history/stm32/AirMonitor_V2/verification/api-PCB_Drc.overwriteCurrentRuleConfiguration.txt

{"ok":true,"value":{"title":"覆写当前设计规则配置","remarks":"将会覆写 PCB 当前的设计规则配置，请注意数据丢失风险","visibility":"beta","params":[{"name":"ruleConfiguration","type":"{ [key: string]: any }","description":"设计规则配置","required":true}],"returns":{"type":"boolean","description":"覆写是否成功"},"example":"```javascript\n// 1. 读取当前设计规则配置（返回 { config, name }，规则数据在 config 里）\nconst current = await eda.pcb_Drc.getCurrentRuleConfiguration();\n\n// 2. 整体写回当前配置（原样写回演示覆写成功，实际使用时可先修改 config 中的字段）\nconst result = await eda.pcb_Drc.overwriteCurrentRuleConfiguration(current.config);\n\nconsole.log('configName:', current.name);\nconsole.log('result:', result);\n```","isAsync":true},"logs":[],"durationMs":184}
