zhuj27519-del/AirMonitor/history/stm32/AirMonitor_V2/verification/api-PCB_Layer.overwriteCurrentPhysicalStackingConfiguration.txt

{"ok":true,"value":{"title":"覆写当前物理叠层配置","remarks":"将会覆写 PCB 当前的物理叠层配置，请注意数据丢失风险","visibility":"alpha","params":[{"name":"physicalStackingConfiguration","type":"{ [key: string]: any }","required":true}],"returns":{"type":"boolean","description":"覆写是否成功"},"isAsync":false},"logs":[],"durationMs":367}
