zhuj27519-del/AirMonitor/history/stm32/AirMonitor_V2/verification/api-PCB_Layer.getAllPhysicalLayerConfigurations.txt

{"ok":false,"error":{"code":"DOC_QUERY_FAILED","message":"[help] eda.PCB_Layer 下不存在方法：getAllPhysicalLayerConfigurations"}}
DOC_QUERY_FAILED: [help] eda.PCB_Layer 下不存在方法：getAllPhysicalLayerConfigurations
