zhuj27519-del/AirMonitor/(commit log)

2026-11-12 Recover AirMonitor firmware, hardware and version history
    [AirMonitor_V1_5.kicad_pcb, AirMonitor_V1_5.kicad_sch, AirMonitor_V2_P1.step, BOM-JLCPCB-SMT.csv, BOM-JLCPCB-all.csv, BOM-manual.csv, BOM-native.csv, BOM.csv]
2026-11-12 Add V4 prototype photos and assembly documentation
